ultrazohm/uz_d_gan_inverter/Produce/Layout/Einzel/README.TXT

READ ME
=======

Project Number	: 1166V10
Date		: 15.11.2020

Layout Drawing by: 
------------------
Michael Kutzsche
Kübrich Ingenieurgesellschaft
mbH & Co. KG
Weißmühle 10
D-96170 Priesendorf
Tel: +49/9549/9877-34
Fax: +49/9549/9877-55

Document descriptions
=====================
Dimension: 100 x 100 mm
min. Drill Hole 0.2 mm
Track-Thickness / Clearance 0.152 mm / 0.152 mm
CU-Thickness  35 µm (all Layer)

Gerberfile for PCB manufacturer:
--------------------------------
*.GTS	Top Solder Mask

*.GTL	Top Layer
*.G1	Mid Layer 1	
*.G2	Mid Layer 2
*.GBL	Bottom Layer

*.GBS	Bottom Solder Mask

*.GKO	Keep Out

*.DRL	NC Drill		(4.2/mm/lead/EIA)
*.TXT	NC Drill		(4.2/mm/lead/ASCII)
*.DDR	NC Drill Tool Table

Gerberfile for Components Assembler:
------------------------------------
*.GTP	Top Solder Paste
*.GBP	Bottom Solder Paste
