ultrazohm/uz_d_gan_inverter/Produce/Lotpaste/Nutzen/README.TXT

READ ME
=======

Project Number	: 1040V00
Date		: 20.02.2011

Layout Drawing by: 
------------------
Michael Kutzsche
Kübrich Ingenieurgesellschaft
mbH & Co. KG
Weißmühle 10
D-96170 Priesendorf
Tel: +49/9549/9877-34
Fax: +49/9549/9877-55

Gerberfile for Components Assembler:
------------------------------------
*.GTP	Top Solder Paste
*.GBP	Bottom Solder Paste
