ultrazohm/uz_d_gan_inverter/docs/Overview.pptx

6x Gate-Signals

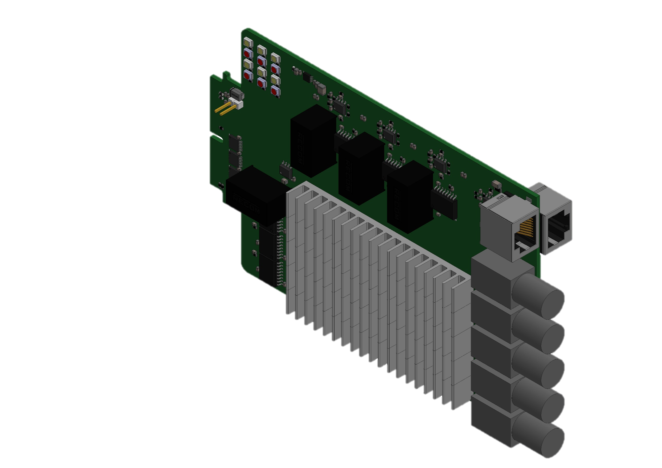
[picture p1: figure]

+24V Fan Connector

3x Phase to DC- Voltage

1x Enable

Fault LEDs

1x DC Current

6x Overcurrent

3x Phase-Current

6x Fault

1x DC+ to DC- Voltage

6x Temperature

4x Current Valid

+24V

+5V

DC+

+3.3V

DC-

GND

Phase a

Phase b

Phase c

## Slide 2

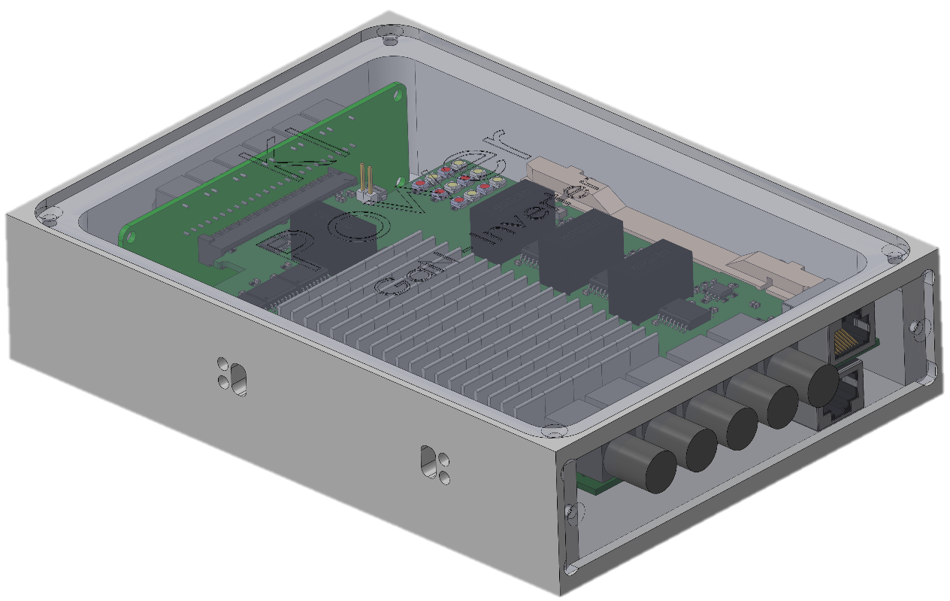
[picture p2: figure]
