ultrazohm/uz_d_gan_inverter/Designs/PCBs/1166V10.PcbDoc.htm

Reporting Options

# File in Newer Format

Date | : | 02.06.2021
Time | : | 14:03:46
Filename | : | C:\ZynqUltra\40_PCB_Design\uz_d_gan_inverter\Designs\PCBs\1166V10.PcbDoc

Version | Warning
Release 20.0 | CAUTION - Support of propagation delay for primitives

This file was generated by a later version of the software
