ultrazohm/uz_d_gan_inverter/CAD_Export/SolidWorks/1166V10.JPG

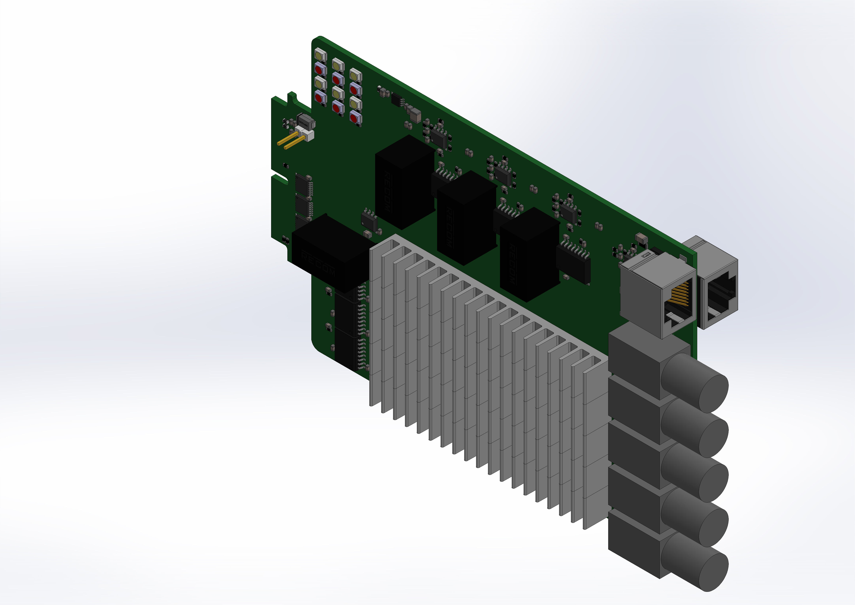
CAD_Export/SolidWorks/1166V10.JPG
