ultrazohm/uz_d_gan_inverter/docs/GaN_Overview.png

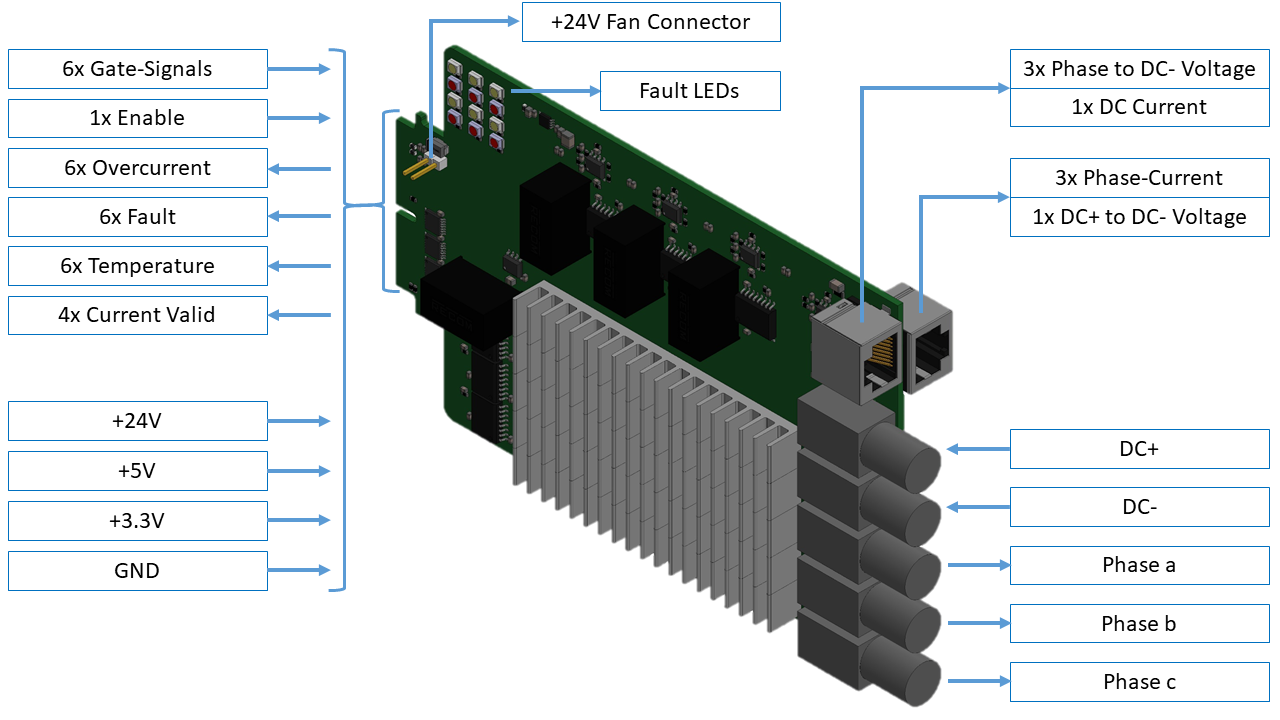
docs/GaN_Overview.png
