ultrazohm/uz_d_gan_inverter/heatsink/heatsink.png

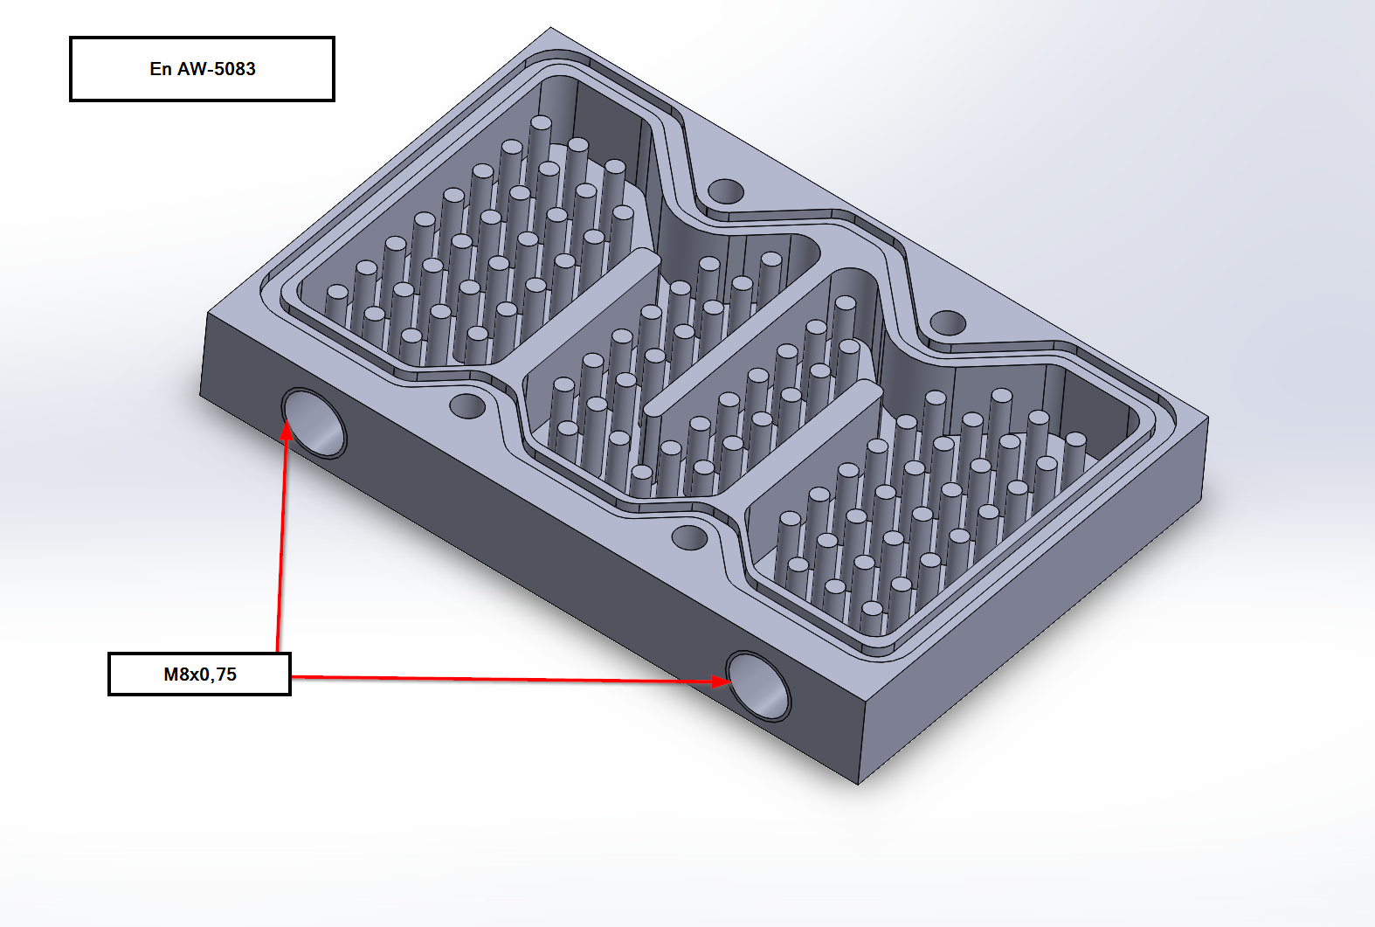
heatsink/heatsink.png
