ultrazohm/uz_d_gan_inverter/heatsink/heatsink_concept.png

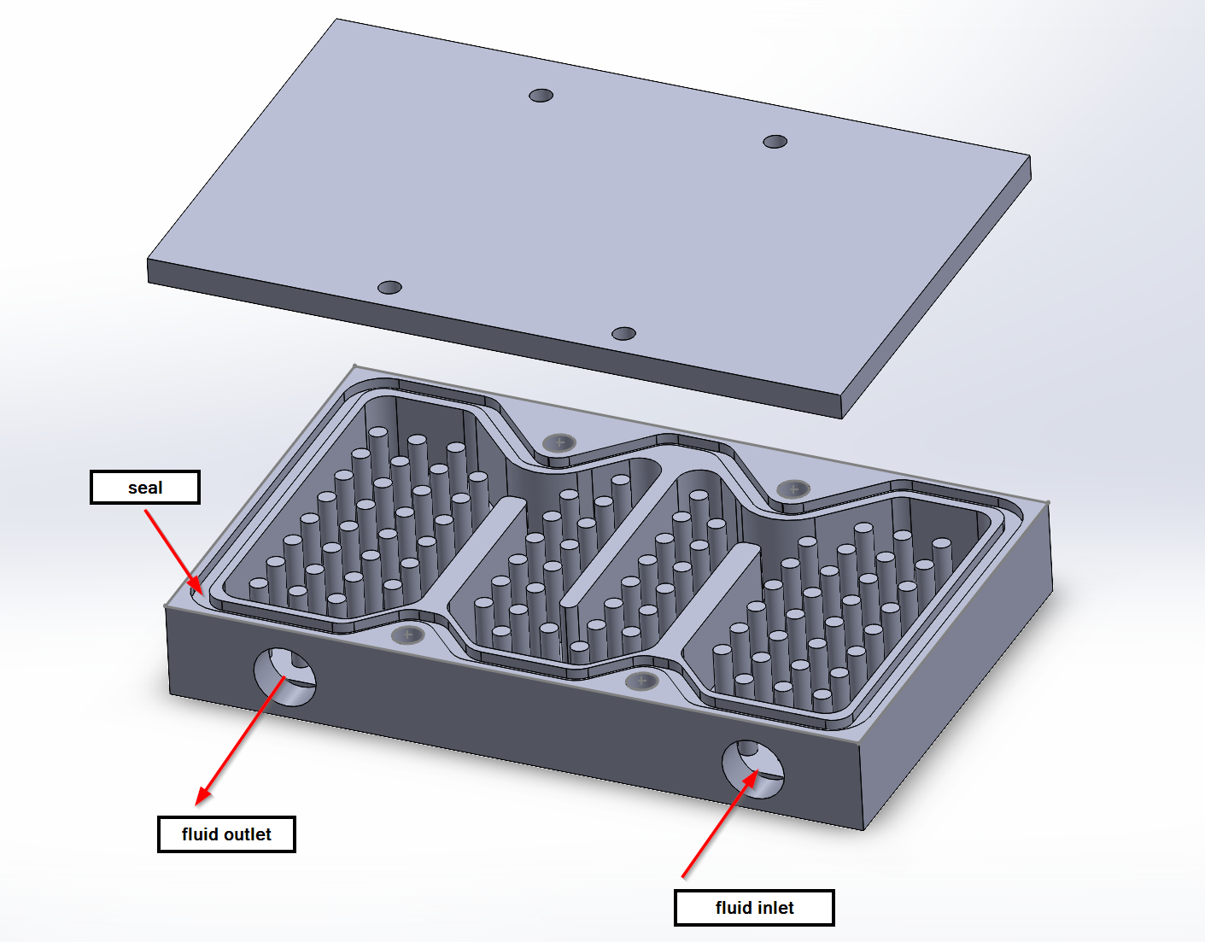
heatsink/heatsink_concept.png
