ultrazohm/uz_d_gan_inverter/heatsink/heatsink_cover.png

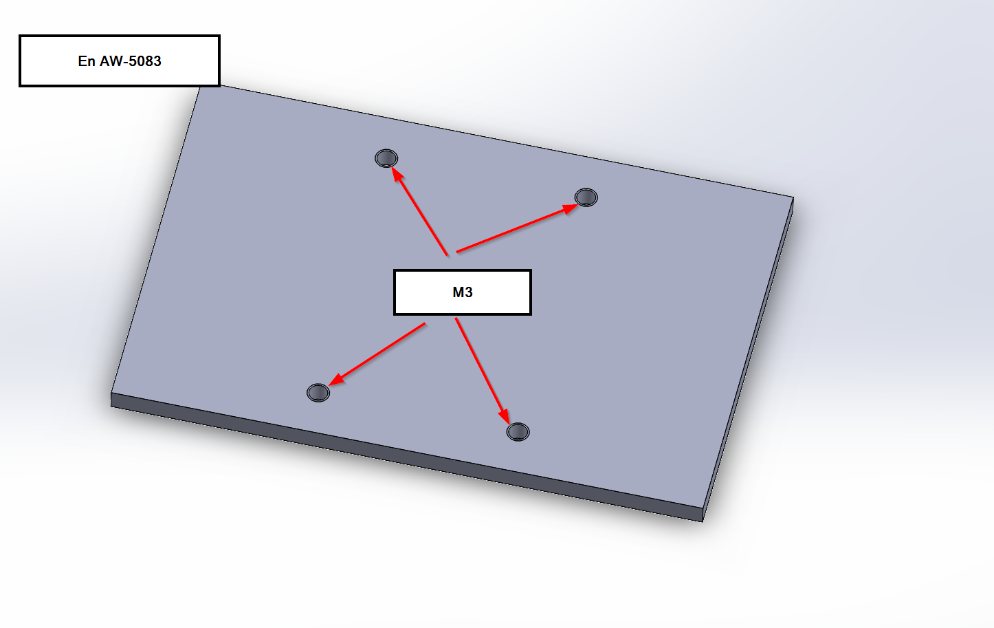
heatsink/heatsink_cover.png
