ultrazohm/uz_d_gan_inverter/heatsink/m8_075_stutzen.png

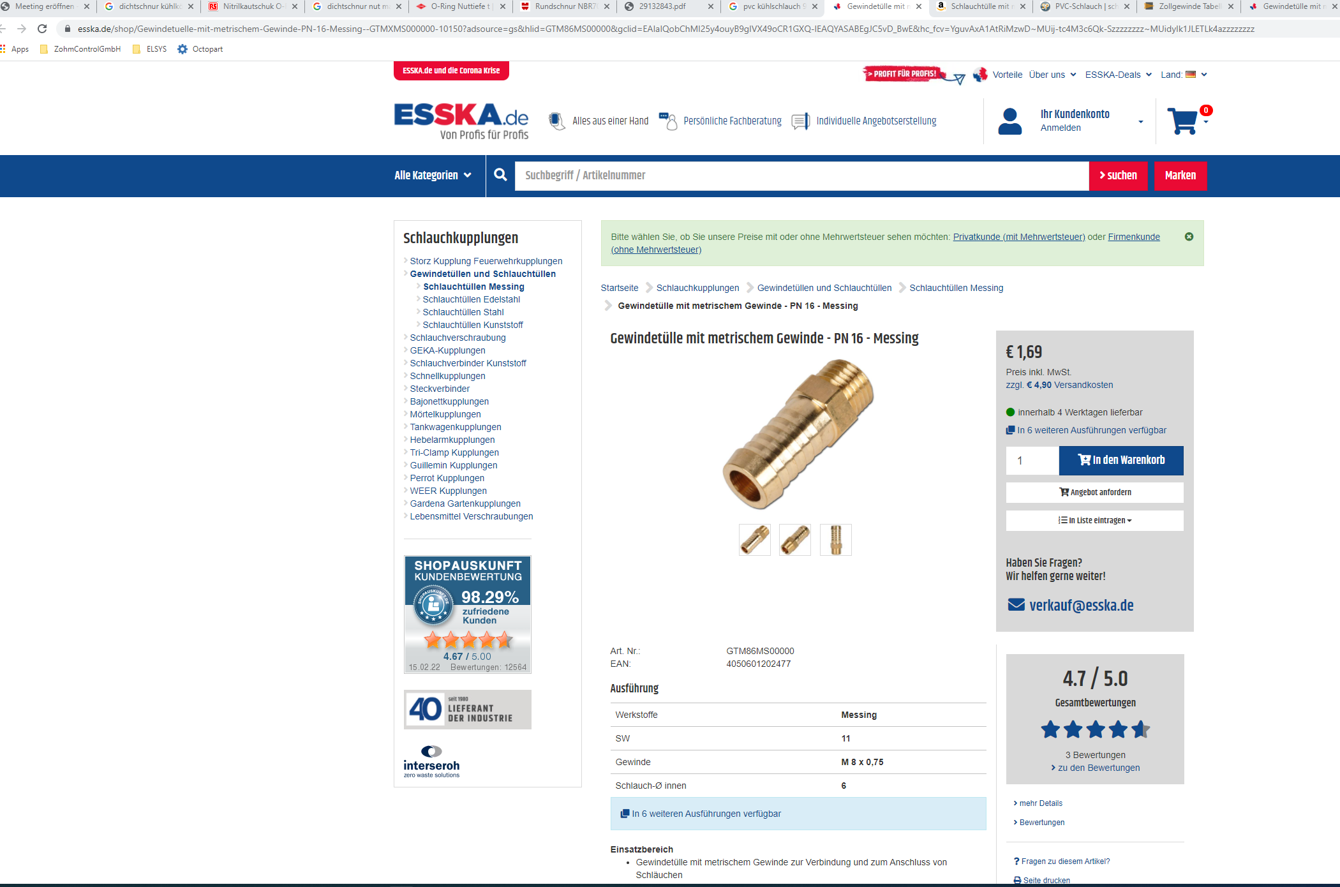
heatsink/m8_075_stutzen.png
