ultrazohm/uz_d_gan_inverter/Produce/Prints/1160V01 Stückliste.xls

Sheet: Stückliste
Stückliste |  |  |  | Bill of Materials for Variant [Variant V01] of Project [1160V01.PrjPCB] (No PCB Document Selected)
Projekt: |  |  |  | 1160V01.PrjPCB |  |  | Beist.: | Beigestell durch:
Variante: |  |  |  | Variant V01 |  |  |  | KI => Kübrich Ing.-Gesellschaft
Letzte(r) Bearbeiter(in) |  |  |  | M. Kutzsche |  |  |  | B => Bestücker
 |  |  |  |  |  |  |  | n.b. => nicht bestückt
Erstellungsdatum: |  |  | 03.09.2020 | 13:52 |  | Tolleranz der Widerstände, wenn nicht anders angegeben: |  |  | 1%
Ausgabedatum: |  |  | 2020-09-03 |  |  | Tolleranz der Kondensatoren, wenn nicht anders angegeben: |  |  | 10%
 |  |  |  |  |  | Tolleranz der Elektrolyt Kondens., wenn nicht anders angegeben: |  |  | 20%
 |  |  |  |  |  | Spannungen bei Kondesatoren, wenn nicht anders angegeben: |  |  | min. 25V
Pos. | Beist. | Stk. | Ref. | Bezeichnung | Wert | Gehäuse | Hersteller | Distributor | Bemerkung
 |  |  |  |  |  |  |  | (Best.-Nr.:)
 |  | Quantity | Designator | Description | Comment | Footprint | Manufacturer | Best.-Nr.
1 | B | 9 | C101, C103, C105, C109, C206, C301, CF203, CF204, CF206 | Capacitor (SMD) | 10µF/10V | 0603-Cap
2 | B | 44 | C102, C104, C106, C108, C110, C201, C207, C208, C302, C303, C304, C305, CF101, CF102, CF201, CF202, CF205, CF207, CF208, CF209, CF210, CF211, CF212, CF213, CF214, CF215, CF217, CF218, CF219, CF220, CF221, CF222, CF223, CF224, CF225, CF226, CF227, CF228, CF229, CF301, CF302, CF303, CF304, CF305 | Capacitor (SMD) | 100nF | 0603-Cap
3 | B | 1 | C107 | Capacitor (SMD) | 10µF/50V | 1206-Cap
4 | B | 2 | C202, C203 | Capacitor (SMD) | 12pF | 0603-Cap
5 | B | 2 | C204, C205 | Capacitor (SMD) | 10nF | 0603-Cap
6 | B | 1 | C306 | Capacitor (SMD) | 1nF | 0603-Cap
7 | B | 2 | CF216, CF230 | Capacitor (SMD) | 2µ2F/6V3 Ceramic | 0603-Cap
8 | B | 1 | CX101 | Capacitor (SMD) | 4n7F/500V | 1206-Cap
9 | B | 1 | D201 | Top 90° LED Green, 20mA, 40mcd, -40-85°C | KA-4040CGSK | LED-KA-4040 4x4mm | Kingbright | Farnell 207-9903
10 | B | 1 | D202 | Top 90° LED Red, 20mA, 80mcd, -40-85°C | KA-4040SURSK | LED-KA-4040 4x4mm | Kingbright | Farnell 207-9899
11 | B | 2 | D203, D204 | Dual Diode Shottky Diode serial 40V/250mA | BAT64-04 | SOT-23 | Siemens | RS 752-7852
12 | B | 1 | D301 | High Conductance Fast Diode | MMSD4148 | SOD-123 | Fairchild Semiconductor
13 | B | 1 | D302 | Asymmetrial DATA Line Protector for CAN 200W/24V | PESD1CAN | SOT-23 | NXP | Farnell 151-0703
14 | B | 1 | IC101 | Low drop Voltage Regulator 3,3V/800mA | LM1117DTX-3.3 | TO-252-3 | National Semiconductor | Farnell 948-6275
15 | B | 1 | IC102 | (TSSOP) 3V LVDS Quad CMOS Differential Receiver | DS90LV048ATMTC | TSSOP-16 | National Semiconductor
16 | B | 1 | IC103 | 3.3V LVDS Driver, 400Mbps | DSLVDS1001DBV | SOT-23-5 | National Semiconductor | Mouser: 595-DSLVDS1001DBVT
17 | B | 1 | IC104 | LDO 1.2V 500mA Regulator | TLV75512PDBVR | SOT-23-5 |  | DigiKey: 296-50409-1-ND
18 | B | 1 | IC201 | C2000 Microcontroller, -40-125°C, 1MB FLASH, 128KB RAM | TMS320F28377SPZPQ | HTQFP-100 (PZP0100N) | Texas Instruments | Mouser: 595-320F28377SPZPQ
19 | B | 1 | IC202 | 16Kx8 (128 Kbit) serial EEPROM -40-85°C (I2C-Interface) | 24CW1280T-I/OT | SOT-23-5 | Microchip | Farnell: 293-1148 (DigiKey: 24CW1280T-I/OTCT-ND)
20 | B | 1 | IC203 | Voltage References 2,5V, Accuracy 1mV, 3 ppm/°C | ADR441BRZ | SOIC-8-N | ANALOG DEVICES | Farnell 127-4158
21 | B | 1 | IC301 | Voltage References 4,096V, Accuracy 1mV, 3 ppm/°C | ADR444BRZ | SOIC-8-N | ANALOG DEVICES | Farnell 127-4151
22 | B | 1 | IC302 | Dual 16-Bit nanoDAC, ±1 LSB INL | AD5065BRUZ | TSSOP-14 | Analog Divices | R&S 697-6849
23 | B | 1 | IC303 | 4,5-36V, Rail-to-Rail OUT Operational Amplifier (-40-125°C) | OPA189IDBV | SOT-23-5 | Texas Instruments | Mouser: 595-OPA189IDBVR
24 | B | 1 | IC304 | 1Mbps Fault-Protected RS-485 Transceivers With Extended Common-Mode Range | SN65HVD1781D | SOIC-8-N | Texax Instruments | Farnell: 170-3343
25 | B | 1 | IC305 | LIN Transreciver, SOIC8 | TJA1020 | SOIC-8-N | NXP | Farnell 880-4583
26 | B | 1 | IC306 | CAN Transreciver, SO8 | TJA1042T/3 | SOIC-8-N | NXP | DigiKey
27 | B | 1 | J101 | ERF8 Serie (Male) 2x20 Pin 90° | ERM8-020-01-L-D-EM2-L-TR | ERM8-020-01-L-D-EM2-L-TR | Samtec | Samtec ERM8-020-01-L-D-EM2-L-TR
28 | B | 1 | J201 | Stiftleiste SMD 2x4 Pol. RM 1,27mm, WE-PHD SMD Connector stehend | Pin Header | IDC-8-SMD-1.27 | Würth Elektronik | WE-62130821021 (WE-62100821021)
29 | B | 14 | K101, K102, K103, K105, K106, K107, K108, K109, K110, K111, K301, K302, K303, K304 | Solid State Relays 150mA/100VDC, NO, 8 Ohm, -40-85°C | CPC1009N | SOP-4 | IXYS | Mouser: 849-CPC1009N
30 | B | 2 | K104, K112 | Ultra-small Package Flat Polarized Relay 5V/20mA (220VDC/5A) | IM03DGR | AGQ | TE | Farnell 162-9011
31 | B | 6 | L101, L102, L103, L201, L202, L301 | Ferrite SMD 600R@100MHz 1A (0603) | 600R@100MHz 1A | 0603-Ind | Wuerth-Elektronik | WE-742792651
32 | B | 1 | LP101 | Leiterplatte 34 x 72 mm, 4 Lagen (4x 35 µm) | 34 x 72 mm, 4 Lagen (4x 35 µm) | LP | Generic Manufacturer
33 | B | 3 | Q101, Q201, Q202 | NPN General Purpose Amplifier | BC817-40 | SOT-23 | Fairchild Semiconductor | Farnell 108-1225
34 | B | 18 | R101, R102, R103, R104, R105, R106, R108, R110, R111, R112, R114, R115, R116, R118, R309, R310, R313, R315 | Resistor SMD | 100R | 0603-Res
35 | B | 4 | R107, R202, R205, R208 | Resistor SMD | 2K2 | 0603-Res
36 | B | 8 | R109, R203, R206, R207, R215, R216, R316, R317 | Resistor SMD | 10K | 0603-Res
37 | B | 2 | R201, R204 | Resistor SMD | 120R | 0603-Res
38 | B | 2 | R209, R213 | Resistor SMD | 91K/0,1%/10ppm/K | 0603-Res
39 | B | 2 | R210, R211 | Resistor SMD | 4K7 | 0603-Res
40 | B | 2 | R212, R214 | Resistor SMD | 10K/0,1%/10ppm/K | 0603-Res
41 | B | 6 | R301, R306, R307, R308, R311, R312 | Resistor SMD | 1K | 0603-Res
42 | B | 1 | R302 | Resistor SMD | 33R | 0603-Res
43 | B | 3 | R303, R304, R305 | Resistor SMD | 10K/0,1%/10ppm/°C | 0603-Res
44 | B | 1 | R314 | Resistor SMD | 120R | 0805-Res
45 | B | 1 | RV201 | Resistor SMD | 0R | 0603-Res
46 | B | 1 | RX101 | Resistor SMD | 1M | 1206-Res
47 | B | 1 | X201 | SMD Quarz 20 MHz 12pF, -40 - +125°C, 20ppm/50ppm, 2,5x3,2mm | ABM8AIG-20.000MHZ-12-2Z-T3 | OSC-3.2x2.5x0.6mm |  | Digi Key: 535-13390-1-ND
Zusätzliches Material

Sheet: Projekt Information
Project Full Path | S:\Jobs\1160V01\Designs\1160V01.PrjPCB
Project Filename | 1160V01.PrjPCB
Variant Name | Variant V01
Data-Source Filename | 1160V01.PrjPCB
Data-Source Full Path | S:\Jobs\1160V01\Designs\1160V01.PrjPCB
Title | Bill of Materials for Variant [Variant V01] of Project [1160V01.PrjPCB] (No PCB Document Selected)
Total Quantity | 161
Report Time | 13:52
Report Date | 03.09.2020
Report Date & Tine | 03.09.2020 13:52
Output Name | Bill of Materials
Output Type | BOM_PartType
Output Generator Name | BOM
Output Generator Description | Bill of Materials
