ultrazohm/uz_d_gan_inverter/Produce/Prints/1160V10 Stückliste.xls

Sheet: Stückliste
Stückliste |  |  |  | Bill of Materials for Variant [Variant V10] of Project [1166V10.PrjPCB] (No PCB Document Selected)
Projekt: |  |  |  | 1166V10.PrjPCB |  |  | Beist.: | Beigestell durch:
Variante: |  |  |  | Variant V10 |  |  |  | KI => Kübrich Ing.-Gesellschaft
Letzte(r) Bearbeiter(in) |  |  |  | M. Kutzsche |  |  |  | B => Bestücker
 |  |  |  |  |  |  |  | n.b. => nicht bestückt
Erstellungsdatum: |  |  | 15.01.2021 | 15:52 |  | Tolleranz der Widerstände, wenn nicht anders angegeben: |  |  | 1%
Ausgabedatum: |  |  | 2021-01-15 |  |  | Tolleranz der Kondensatoren, wenn nicht anders angegeben: |  |  | 10%
 |  |  |  |  |  | Tolleranz der Elektrolyt Kondens., wenn nicht anders angegeben: |  |  | 20%
 |  |  |  |  |  | Spannungen bei Kondesatoren, wenn nicht anders angegeben: |  |  | min. 25V
Pos. | Beist. | Stk. | Ref. | Bezeichnung | Wert | Gehäuse | Hersteller | Distributor | Bemerkung
 |  |  |  |  |  |  |  | (Best.-Nr.:)
 |  | Quantity | Designator | Description | Comment | Footprint | Manufacturer | Best.-Nr.
1 | B | 1 | C101 | Capacitor (SMD) | 10µF/10V | 0805-Cap
2 | B | 63 | C102, C104, C107, C109, C208, C211, C217, C224, C228, C235, C308, C311, C317, C330, C408, C411, C417, C430, C502, C512, C518, CF101, CF102, CF103, CF104, CF105, CF106, CF107, CF108, CF109, CF110, CF111, CF112, CF204, CF209, CF210, CF211, CF213, CF214, CF304, CF306, CF307, CF308, CF310, CF311, CF404, CF406, CF407, CF408, CF410, CF411, CF501, CF502, CF504, CF505, CF507, CF508, CF509, CF510, CF511, CF512, CF513, CF514 | Capacitor (SMD) | 100nF | 0603-Cap
3 | B | 1 | C103 | Capacitor (SMD) | 2µ2F/10V | 0805-Cap
4 | B | 1 | C105 | Capacitor (SMD) | 47µF/10V | 1210-Cap
5 | B | 2 | C106, C108 | Capacitor (SMD) | 10µF/10V | 0603-Cap
6 | B | 6 | C201, C225, C301, C322, C401, C422 | Capacitor (SMD) | 10µF/25V | 0805-Cap
7 | B | 3 | C202, C302, C402 | Capacitor (SMD) | 22nF/1KV | 2220-Cap
8 | B | 6 | C203, C204, C303, C304, C403, C404 | Capacitor (SMD) | 100nF/630V | 2220-Cap
9 | B | 10 | C205, C305, C405, C521, C522, C523, C524, C525, C526, C527 | Capacitor (SMD) | 1µF/630V | 2220-Cap
10 | B | 8 | C206, C207, C222, C223, C306, C307, C406, C407 | Capacitor (SMD) | 10µF/50V | 1206-Cap
11 | B | 6 | C209, C226, C309, C323, C409, C423 | Capacitor (SMD) | 220nF | 0603-Cap
12 | B | 6 | C210, C227, C310, C324, C410, C424 | Capacitor (SMD) | 2µ2F/25V | 0805-Cap
13 | B | 4 | C212, C312, C412, C505 | Capacitor (SMD) | 1µF/25V | 1206-Cap
14 | B | 8 | C213, C218, C313, C318, C413, C418, C506, C513 | Capacitor (SMD) | 1nF | 1206-Cap
15 | B | 5 | C215, C315, C415, C510, CF305 | Capacitor (SMD) | 1µF/25V | 0603-Cap
16 | B | 4 | C216, C316, C416, C511 | Capacitor (SMD) | 1nF | 0603-Cap
17 | B | 4 | C219, C319, C419, C514 | Capacitor (SMD) | 100nF | 1206-Cap
18 | B | 4 | C220, C320, C420, C515 | Capacitor (SMD) | 8n2F | 0603-Cap
19 | B | 6 | C221, C231, C321, C326, C421, C426 | Capacitor (SMD) | 68pF | 0603-Cap
20 | B | 1 | C229 | Capacitor (SMD) | 10nF | 0603-Cap
21 | B | 16 | C232, C237, C327, C332, C427, C432, C501, C508, C509, C520, C528, C531, C533, C537, C538, C542 | Capacitor (SMD) | 22pF | 0603-Cap
22 | B | 24 | C233, C234, C236, C328, C329, C331, C428, C429, C431, C503, C504, C507, C516, C517, C519, C529, C530, C532, C534, C535, C536, C539, C540, C541 | Capacitor (SMD) | 2n2F | 0603-Cap
23 | B | 9 | CF201, CF202, CF205, CF206, CF207, CF301, CF302, CF401, CF402 | Capacitor (SMD) | 22µF/16V | 0805-Cap
24 | B | 13 | CF203, CF208, CF212, CF215, CF303, CF309, CF312, CF403, CF405, CF409, CF412, CF503, CF506 | Capacitor (SMD) | 1µF/10V | 0603-Cap
25 | B | 1 | CX101 | Capacitor (SMD) | 4n7F/500V | 1206-Cap
26 | B | 1 | D101 | Schottky Barrier Rectifier Vr=60V If=1A | B160 | SMA | General Semiconductor | Farnell 145-6528RL
27 | B | 6 | D201, D206, D301, D306, D401, D406 | Silicon Carbide Schottky Diode Vr=1200V If=1A | GB01SLT12-214 | DO-214 (SMB) | GeneSiC Semiconductor | DigiKey: 1242-1169-1-ND
28 | B | 6 | D202, D204, D302, D304, D402, D404 | Top LED Super red, 2mA, 18mcd, -40-100°C | VLMS30K1L2-GS08 | PLCC-2_rot | Vishay | Farnell 132-8349
29 | B | 6 | D203, D205, D303, D305, D403, D405 | Top LED Yellow, 2mA, 18mcd, -40-100°C | VLMY3001 | PLCC-2_gelb | Vishay | ???
30 | B | 3 | IC101, IC105, IC109 | Dual 4-Input AND Gate with Schmitt Trigger Input | SN74HCS21PWR | TSSOP-14 | Texas Instrument | DigiKey: 296-SN74HCS21PWRCT-ND
31 | B | 3 | IC102, IC106, IC110 | (VSSOP) Dual 2-Input Positive AND Gate | SN74AUP2G08DCUR | VSSOP-8 | Texas Instrument
32 | B | 3 | IC103, IC107, IC111 | Dual Buffer with Schmitt Trigger Input | SN74LVC2G17DBV | SOT-23-6 | Texas Instrument | Farnell 147-0776 (SOT23-6), 128-7569 (SC-70)
33 | B | 3 | IC104, IC108, IC113 | Dual Inverter with Schmitt Trigger Input | SN74LVC2G14DBV | SOT-23-6 | Texas Instrument
34 | B | 1 | IC112 | Voltage References 2,5V, 2ppm/°C, Low Noise 0,25ppm | LTC6655BHMS8-2.5 | MSOP-8 (RM-8) | Linear Technology | Farnell 229-5508
35 | B | 4 | IC201, IC301, IC401, IC501 | ±250 mV Input Voltage Range, Reinforced Isolated Amplifier and High Bandwidth of 300 kHz | AMC3301DWE | SOIC-16-W - 8.1mm | Texas Instruments | DigiKey: 296-AMC3301DWE-ND
36 | B | 6 | IC202, IC204, IC302, IC303, IC402, IC403 | Quad-CH 100Mbps Isolators 1 IN/3 OUT, 5000V Reinforced, (-40-150°C) | ISO7741FEDWQ1 | SOIC-16-W - 8.1mm | Anaolog Devices | DigiKey: 296-ISO7741FEDWQ1-ND
37 | B | 1 | IC203 | LDO 5V/500mA, Vin 20V (-40-125°C) | LT1763IS8-5#PBF | SOIC-8-N | Linear Technology | Farnell 229-5214
38 | B | 4 | IC205, IC304, IC404, IC503 | 2V Input, Automotive High-Impedance, Reinforced Isolated Amplifier for Voltage Sensing | AMC1311BQDWVRQ1 | SOIC-8-W | Texas Instruments | Mouser: 595-AMC1311BQDWVRQ1
39 | B | 8 | IC206, IC305, IC405, IC502, IC504, IC505, IC506, IC507 | Fully Differential ADC Drivers (-40-125°C) | ADA4940-1ARZ | SOIC-8-N | ANALOG DEVICES | Farnell 209-6178
40 | B | 2 | J103, J104 | SMD CAT3 RJ-45 Connector | RJ-45 | WE-634008149821 | Würth Elektronik | WE-634008149821
41 | B | 3 | J201, J301, J401 | Labor Winkelbuchsen 4mm Schwarz | MC - SLB4-I/90 Schwarz | SLB4-I/90 - 4mm | Multi-Contact | Farnell: 108-5521
42 | B | 1 | J501 | Labor Winkelbuchsen 4mm Rot | MC - SLB4-I/90 Rot | SLB4-I/90 - 4mm | Multi-Contact | Farnell: 413-0261
43 | B | 1 | J502 | Labor Winkelbuchsen 4mm Blau | FCR7350L Blau | SLB4-I/90 - 4mm - CLIFF | CLIFF Electronic | Farnell: 185-4511
44 | B | 3 | L101, L102, L103 | Ferrite SMD 600R@100MHz 1A (0603) | 600R@100MHz 1A | 0603-Ind | Wuerth-Elektronik | WE-742792651
45 | B | 8 | L201, L202, L204, L205, L301, L302, L401, L402 | 100µH, 60/120mA. (1007), -40-105°C | 100µH/120mA | 1007-IND (2518) | Taiyo Yuden | DigiKey: 587-2192-1-ND
46 | B | 6 | L203, L206, L303, L304, L403, L404 | Power Choke 4u7H 1,1A | 4u7H 1,1A | 2.0mm x 1.6mm | Delta Electronics/Cyntec | DigiKey: 2037-SDEM20161T-4R7MSCT-ND
47 | B | 1 | LP101 | Leiterplatte 100 x 156 mm, 8 Lagen (8x 70 µm) | 100 x 156 mm, 8 Lagen (8x 70 µm) | LP | Generic Manufacturer
48 | B | 3 | PS201, PS301, PS401 | DC/DC Converter 24V to 12V, 1W, 84mA (unregulated) 6,4KVDC Rainforced | R24P12S/P/X2/R6.4 | SIP-7 Single - X2 | Recom | Mouser: 919-R24P12SX2PR6.4
49 | B | 1 | PS202 | DC/DC Converter 24V to 12V, 2W, 167mA (unregulated) 6,4KVDC Rainforced | R24P212S/P/X2/R6.4 | SIP-7 Single - X2 | Recom | Mouser: 919-R24P212SX2PR6.4
50 | B | 6 | Q201, Q202, Q301, Q302, Q401, Q402 | GaN FET Power Stage With Cycle-by-cycle Overcurrent Protection 600V/40A/30mOhm | LMG3425R030RQZT | VQFN-54 (RQZ0054) | Texas Instruments | TI-Shop
51 | B | 5 | R101, R203, R303, R403, R502 | Resistor SMD | 10K | 0603-Res
52 | B | 1 | R103 | Resistor SMD | 0R | 0603-Res
53 | B | 12 | R201, R202, R204, R207, R301, R302, R304, R307, R401, R402, R404, R407 | Resistor SMD | 470R | 0603-Res
54 | B | 4 | R205, R212, R312, R412 | Resistor SMD | 20K | 0603-Res
55 | B | 6 | R206, R213, R306, R313, R406, R413 | Resistor SMD | 220R | 0603-Res
56 | B | 38 | R208, R214, R216, R218, R221, R223, R308, R314, R316, R318, R321, R323, R408, R414, R416, R418, R421, R423, R503, R505, R506, R508, R513, R515, R519, R521, R525, R527, R529, R531, R532, R534, R536, R538, R541, R543, R544, R546 | Resistor SMD | 49R9 | 0603-Res
57 | B | 8 | R209, R210, R309, R310, R409, R410, R516, R517 | Resistor SMD | 10R | 0603-Res
58 | B | 3 | R211, R311, R411 | 18mOhm, 3W, 0,5%, 50ppm/°C | 0.018R | 2512 | Milticomp | Farnell: 282-8111
59 | B | 16 | R215, R225, R315, R325, R415, R425, R501, R509, R510, R523, R524, R528, R535, R539, R540, R547 | Resistor SMD | 2K | 0603-Res
60 | B | 16 | R217, R222, R317, R322, R417, R422, R504, R507, R514, R520, R526, R530, R533, R537, R542, R545 | Resistor SMD | 1K | 0603-Res
61 | B | 8 | R219, R220, R319, R320, R419, R420, R511, R512 | Resistor SMD 1M/0,1%/3KV/2W/25ppm/°C | 1M | 2512-Res |  | DigiKey: HVCB2512BDE1M00CT-ND
62 | B | 4 | R224, R324, R424, R522 | Resistor SMD | 6K65/0,1%/10ppm | 0603-Res
63 | B | 2 | R305, R405 | Resistor SMD | 15K | 0603-Res
64 | B | 1 | R518 | 10mOhm, 3W, 1%, 50ppm/°C | 0.010R | 2512 | TT Electronics | Farnell: 207-9429
65 | B | 1 | RX101 | Resistor SMD | 1M | 1206-Res
Zusätzliches Material

Sheet: Projekt Information
Project Full Path | S:\Jobs\1166V10\Designs\1166V10.PrjPCB
Project Filename | 1166V10.PrjPCB
Variant Name | Variant V10
Data-Source Filename | 1166V10.PrjPCB
Data-Source Full Path | S:\Jobs\1166V10\Designs\1166V10.PrjPCB
Title | Bill of Materials for Variant [Variant V10] of Project [1166V10.PrjPCB] (No PCB Document Selected)
Total Quantity | 427
Report Time | 15:52
Report Date | 15.01.2021
Report Date & Tine | 15.01.2021 15:52
Output Name | Bill of Materials
Output Type | BOM_PartType
Output Generator Name | BOM
Output Generator Description | Bill of Materials
