ultrazohm/uz_d_gan_inverter/CAD_Export/SolidWorks/Assembly_water_cooled.SLDASM

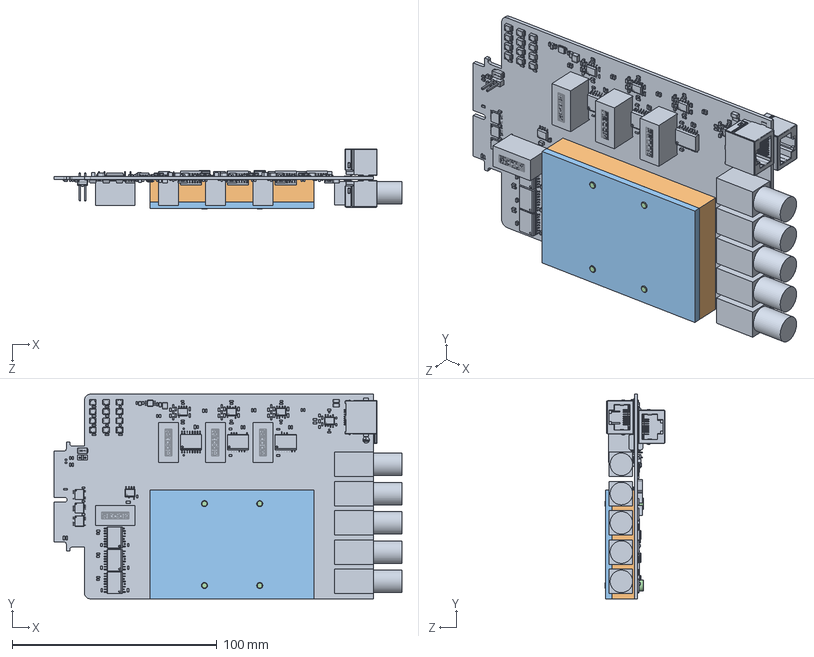
[picture p9: CAD file, 2022-02-21]
CAD_Export/SolidWorks/Assembly_water_cooled.SLDASM
170.0 x 100.0 x 29.5 mm
1166V10
heatsink2
heatsink_plate
socket head cap screw 4762_din x 4
