ultrazohm/uz_d_gan_inverter/heatsink/heatsink_assembly.SLDASM

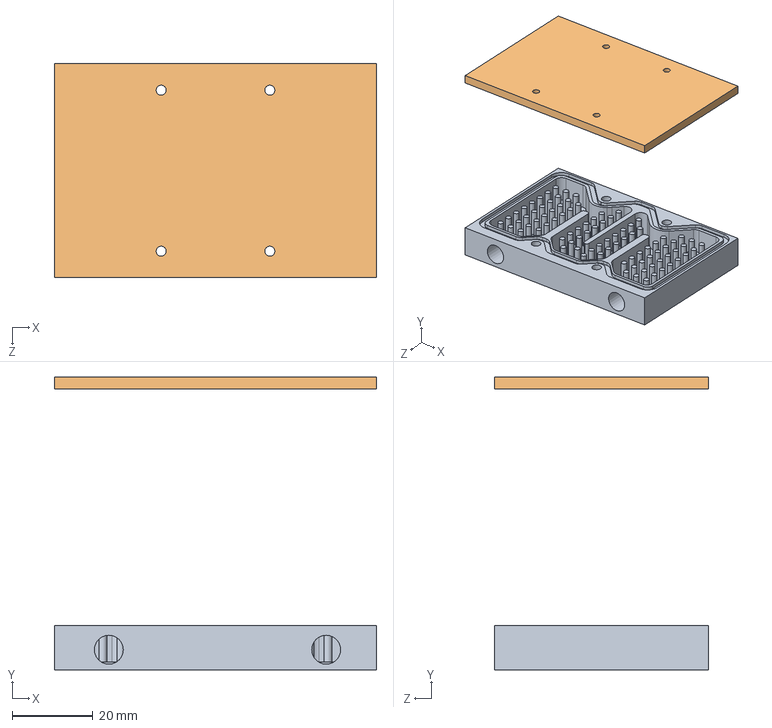
[picture p10: CAD file, 2022-02-21]
heatsink/heatsink_assembly.SLDASM
80.0 x 72.7 x 53.1 mm
heatsink2
heatsink_plate
