ultrazohm/uz_d_gan_inverter/CAD_Export/FrontPanel/UZ_D_GaN_Inverter.dxf

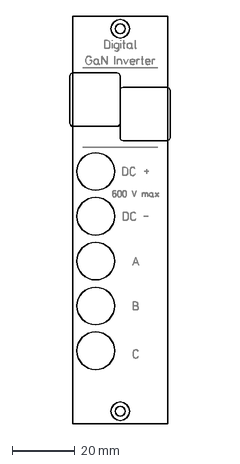
[picture p11: CAD file, 2021-09-15]
CAD_Export/FrontPanel/UZ_D_GaN_Inverter.dxf
32.0 x 130.0 mm
