ultrazohm/uz_d_gan_inverter/heatsink/heatsink2.STEP

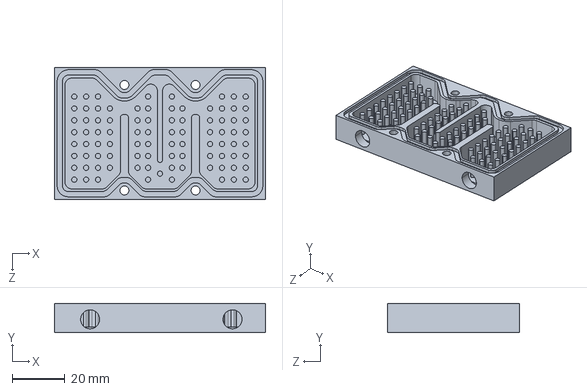
[picture p12: CAD file, 2022-02-21]
heatsink/heatsink2.STEP
80.0 x 11.0 x 50.0 mm
