ultrazohm/uz_d_gan_inverter/heatsink/step/heatsink.STEP

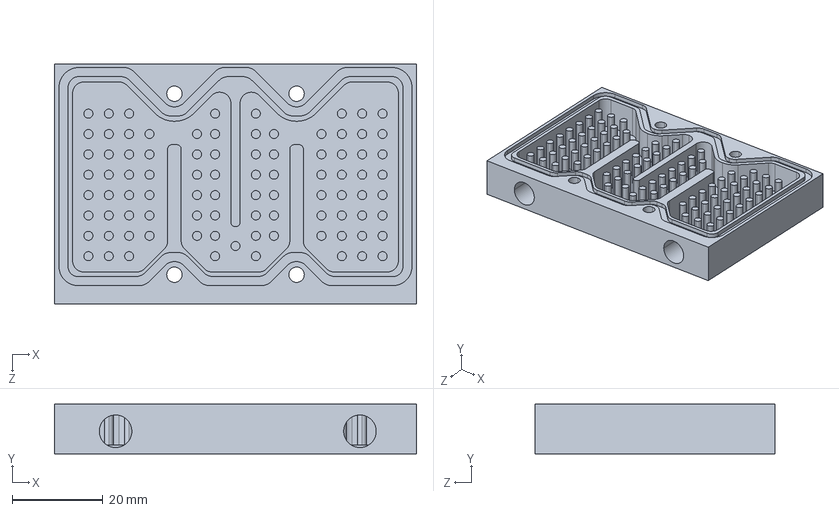
[picture p13: CAD file, 2022-02-21]
heatsink/step/heatsink.STEP
80.0 x 11.0 x 53.1 mm
