ultrazohm/uz_d_gan_inverter/CAD_Export/FrontPanel/UZ_D_GaNInverter_Panel.SLDPRT

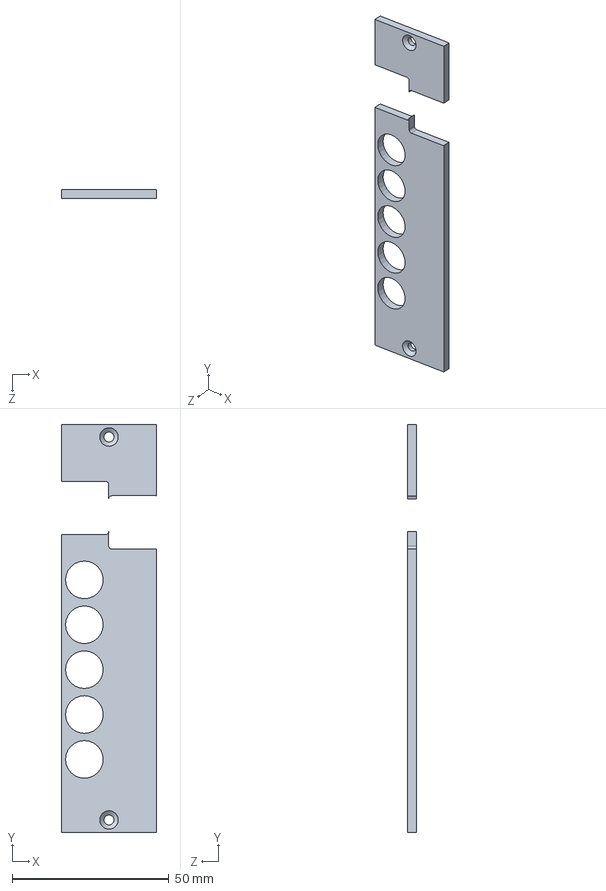
[picture p14: CAD file, 2021-09-15]
CAD_Export/FrontPanel/UZ_D_GaNInverter_Panel.SLDPRT
30.2 x 130.0 x 3.00 mm
