ultrazohm/uz_d_gan_inverter/heatsink/step/heatsink_cover.STEP

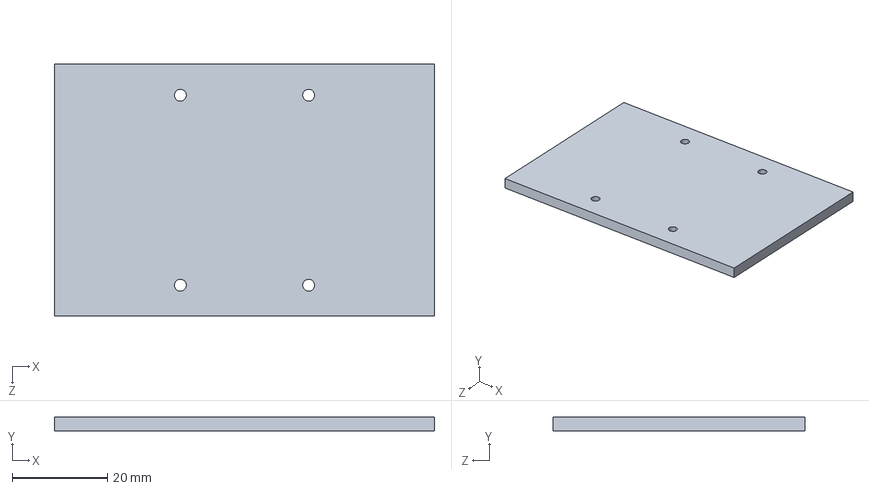
[picture p15: CAD file, 2022-02-21]
heatsink/step/heatsink_cover.STEP
80.0 x 3.00 x 53.1 mm
