ultrazohm/uz_d_gan_inverter/(list of files, cad)

Other CAD files:
heatsink/heatsink_plate.SLDPRT
heatsink/heatsink.SLDPRT
heatsink/heatsink2.SLDPRT
heatsink/step/heatsink.SLDPRT
