ultrazohm/uz_d_gan_inverter/measurements/20210902_Messung_GaN.xlsx

Messung GaN Adapter Board
HW Version: | 1166V10
Datum: | 2021-09-02
Lastmaschine
Drehzahl: | -500 | rpm
Prüfling:
U_ZK | 48 V |  |  | 24 V | 36 V | 36
PWM Frequenz | 100 kHz |  |  | 100 kHz | 200 kHz | 200 kHz
Totzeit | 18 ns |  |  | 18 ns | 50 ns | 50 ns
iq_strom | 20 | 20 | 25 | 25 | 10 | 15
DC Strom | 2.5 | 2.5 | 3.6 | 6.8 | 2.1 | 3.3
Temperatur | >165 °C an H1 | 100 °C | 147 °C an H1 | 151 °C an H3 | 90 °C an H2 | 131 °C an H2
Kühlung | ohne Lüfter | mit Lüfter | mit Lüfter | mit Lüfter | ohne Lüfter | ohne Lüfter
Notiz | nach 2min OT | nach 5min, Eingeschwungen | nach 5min, Eingeschwungen | nach 5min, Eingeschwungen | nach 1h, Eingeschwungen
 |  |  |  |  |  | 118.8
