ultrazohm/uz_d_gan_inverter/Produce/Prints/1166V10 Schematic.pdf

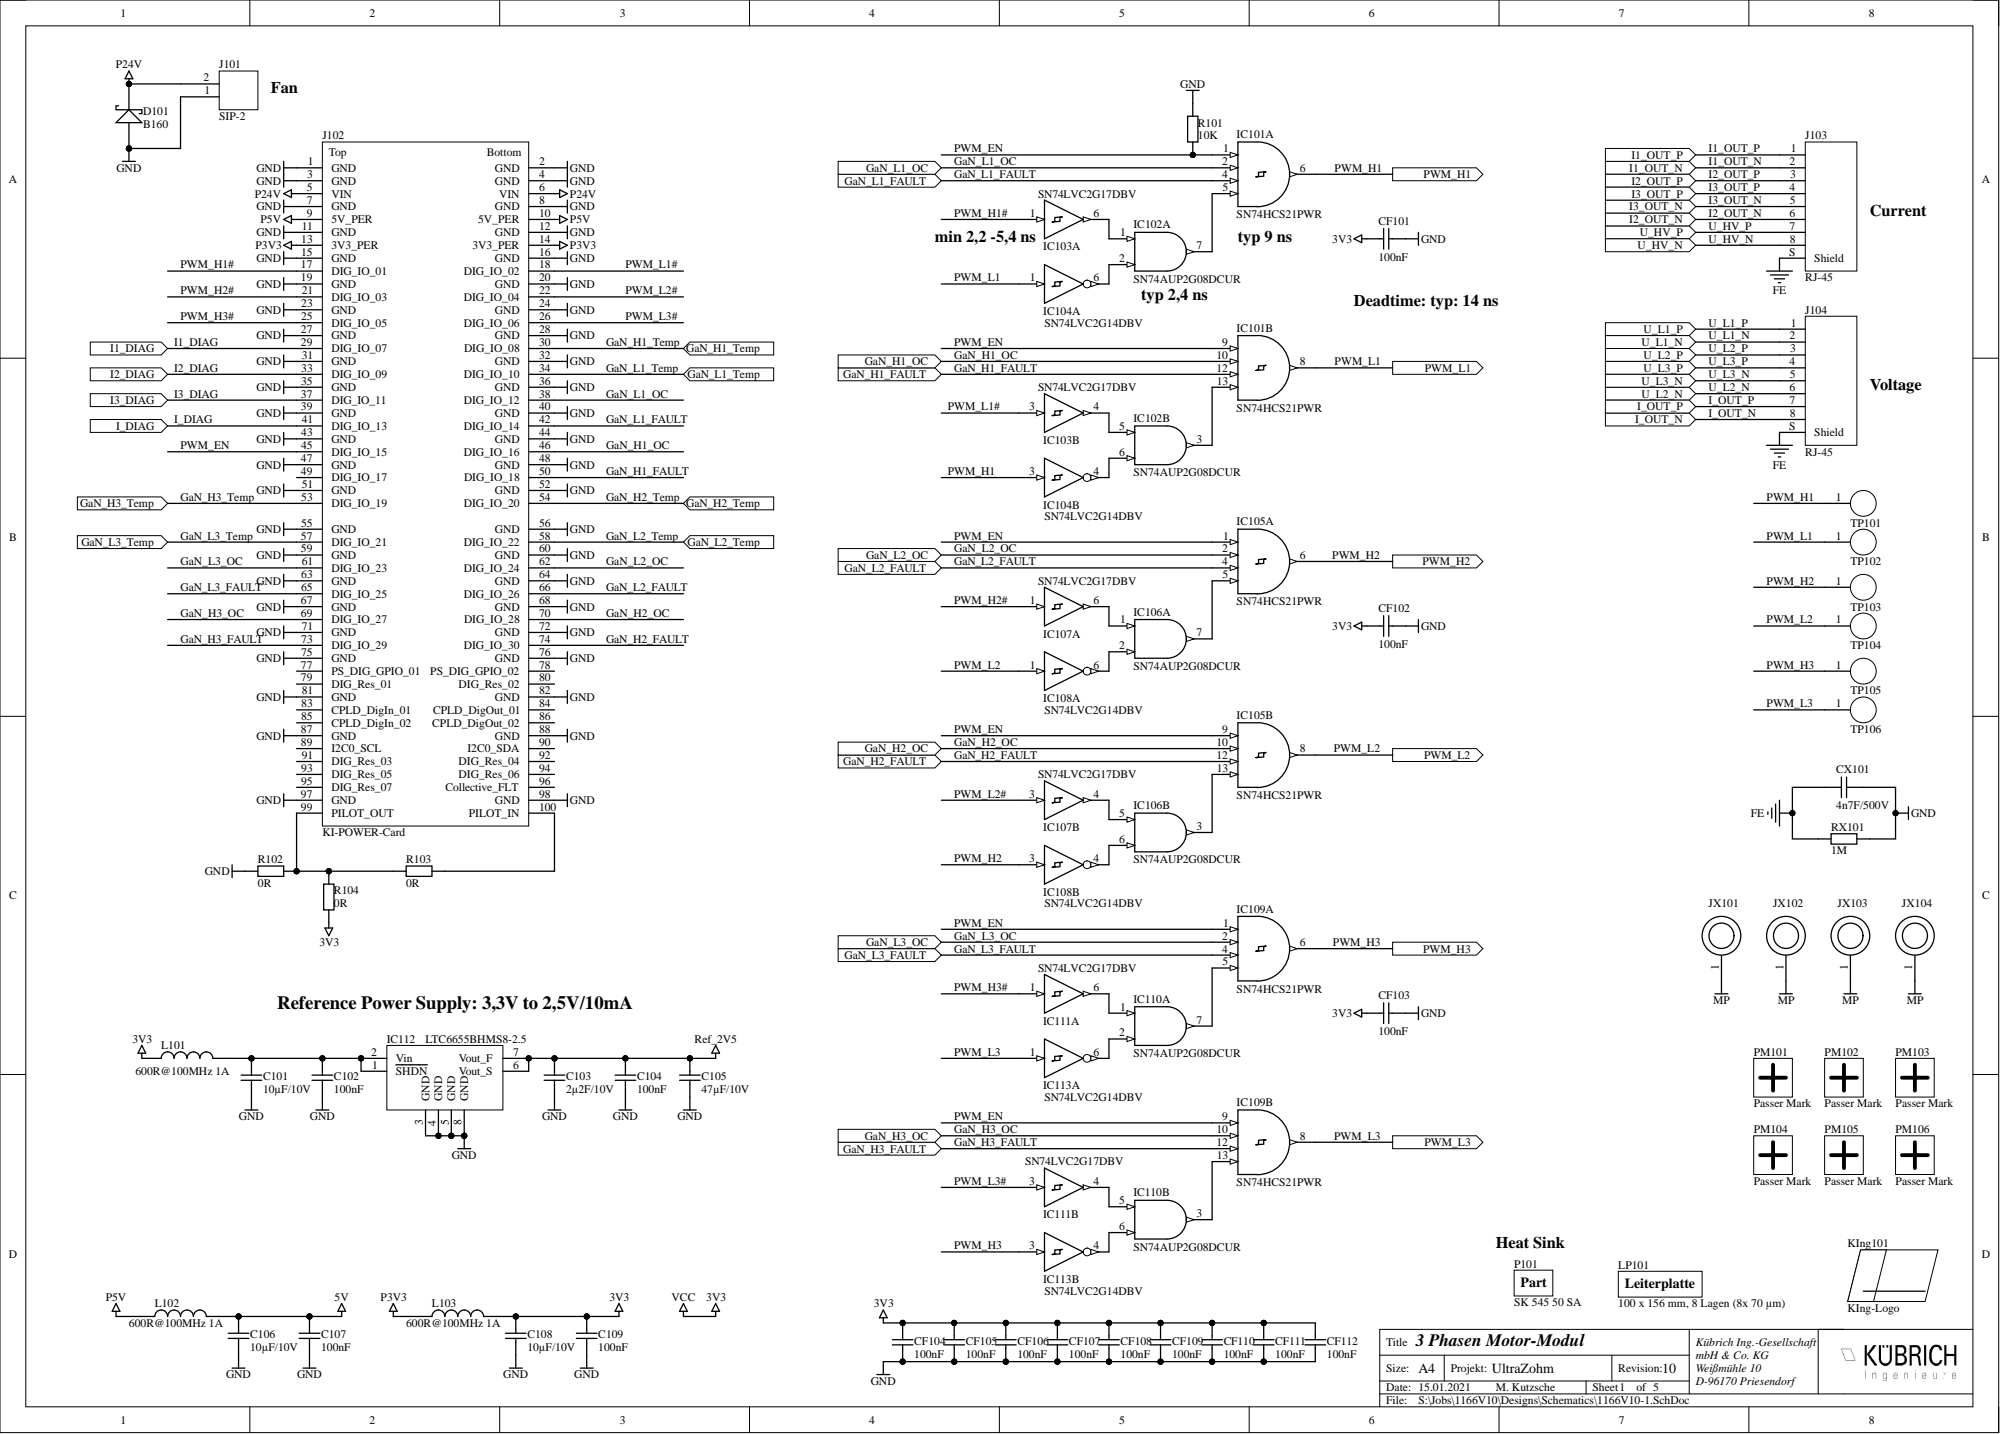
[picture p16: page 1]

Reference Power Supply: 3,3V to 2,5V/10mA

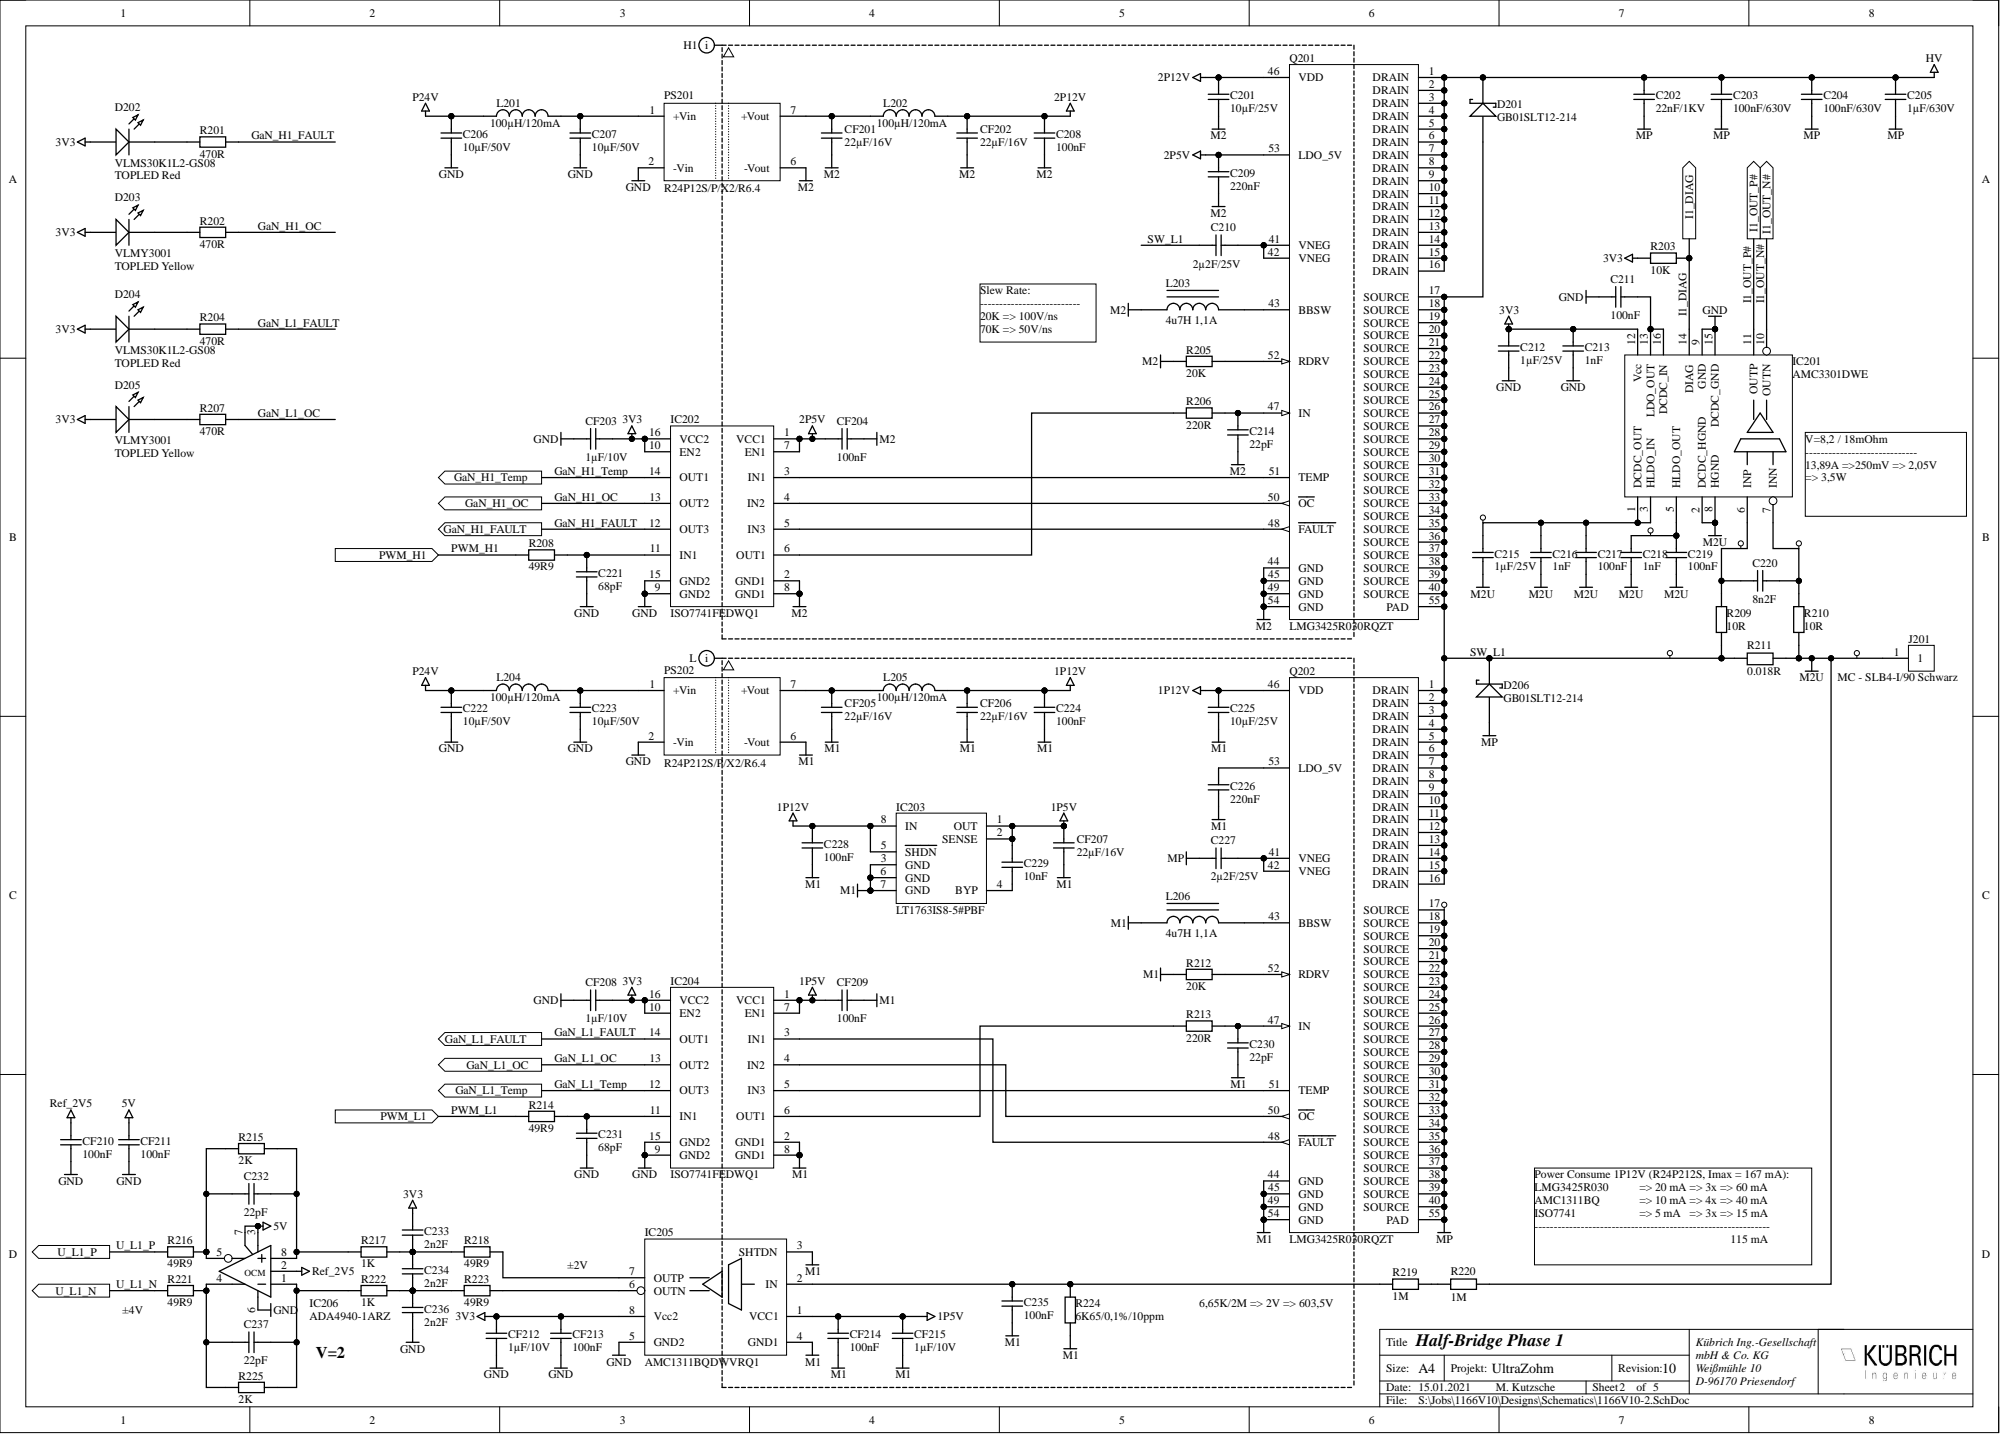
[picture p17: page 2]

2P5V CF204 | C214 220R M2 | TEMP 51

VCC2 16 | EN1 IN1 IN2 IN3
EN2 10 | | 7 | 100nF

OUT1 14 OUT2 13 OUT3 12 IN1 11 | 3

5 | | FAULT 48

C228 | SHDN 5

GND 3

VCC2 16 | EN1 IN2 IN3 OUT1 GND1
EN2 10 | 7

TEMP 51

GND2 9 GND2 15 | | | GND 44

2 | FAULT 48

Power Consume 1P12V (R24P212S, Imax = 167 mA):

S:\Jobs\1166V10\Designs\Schematics\1166V10-2.SchDoc

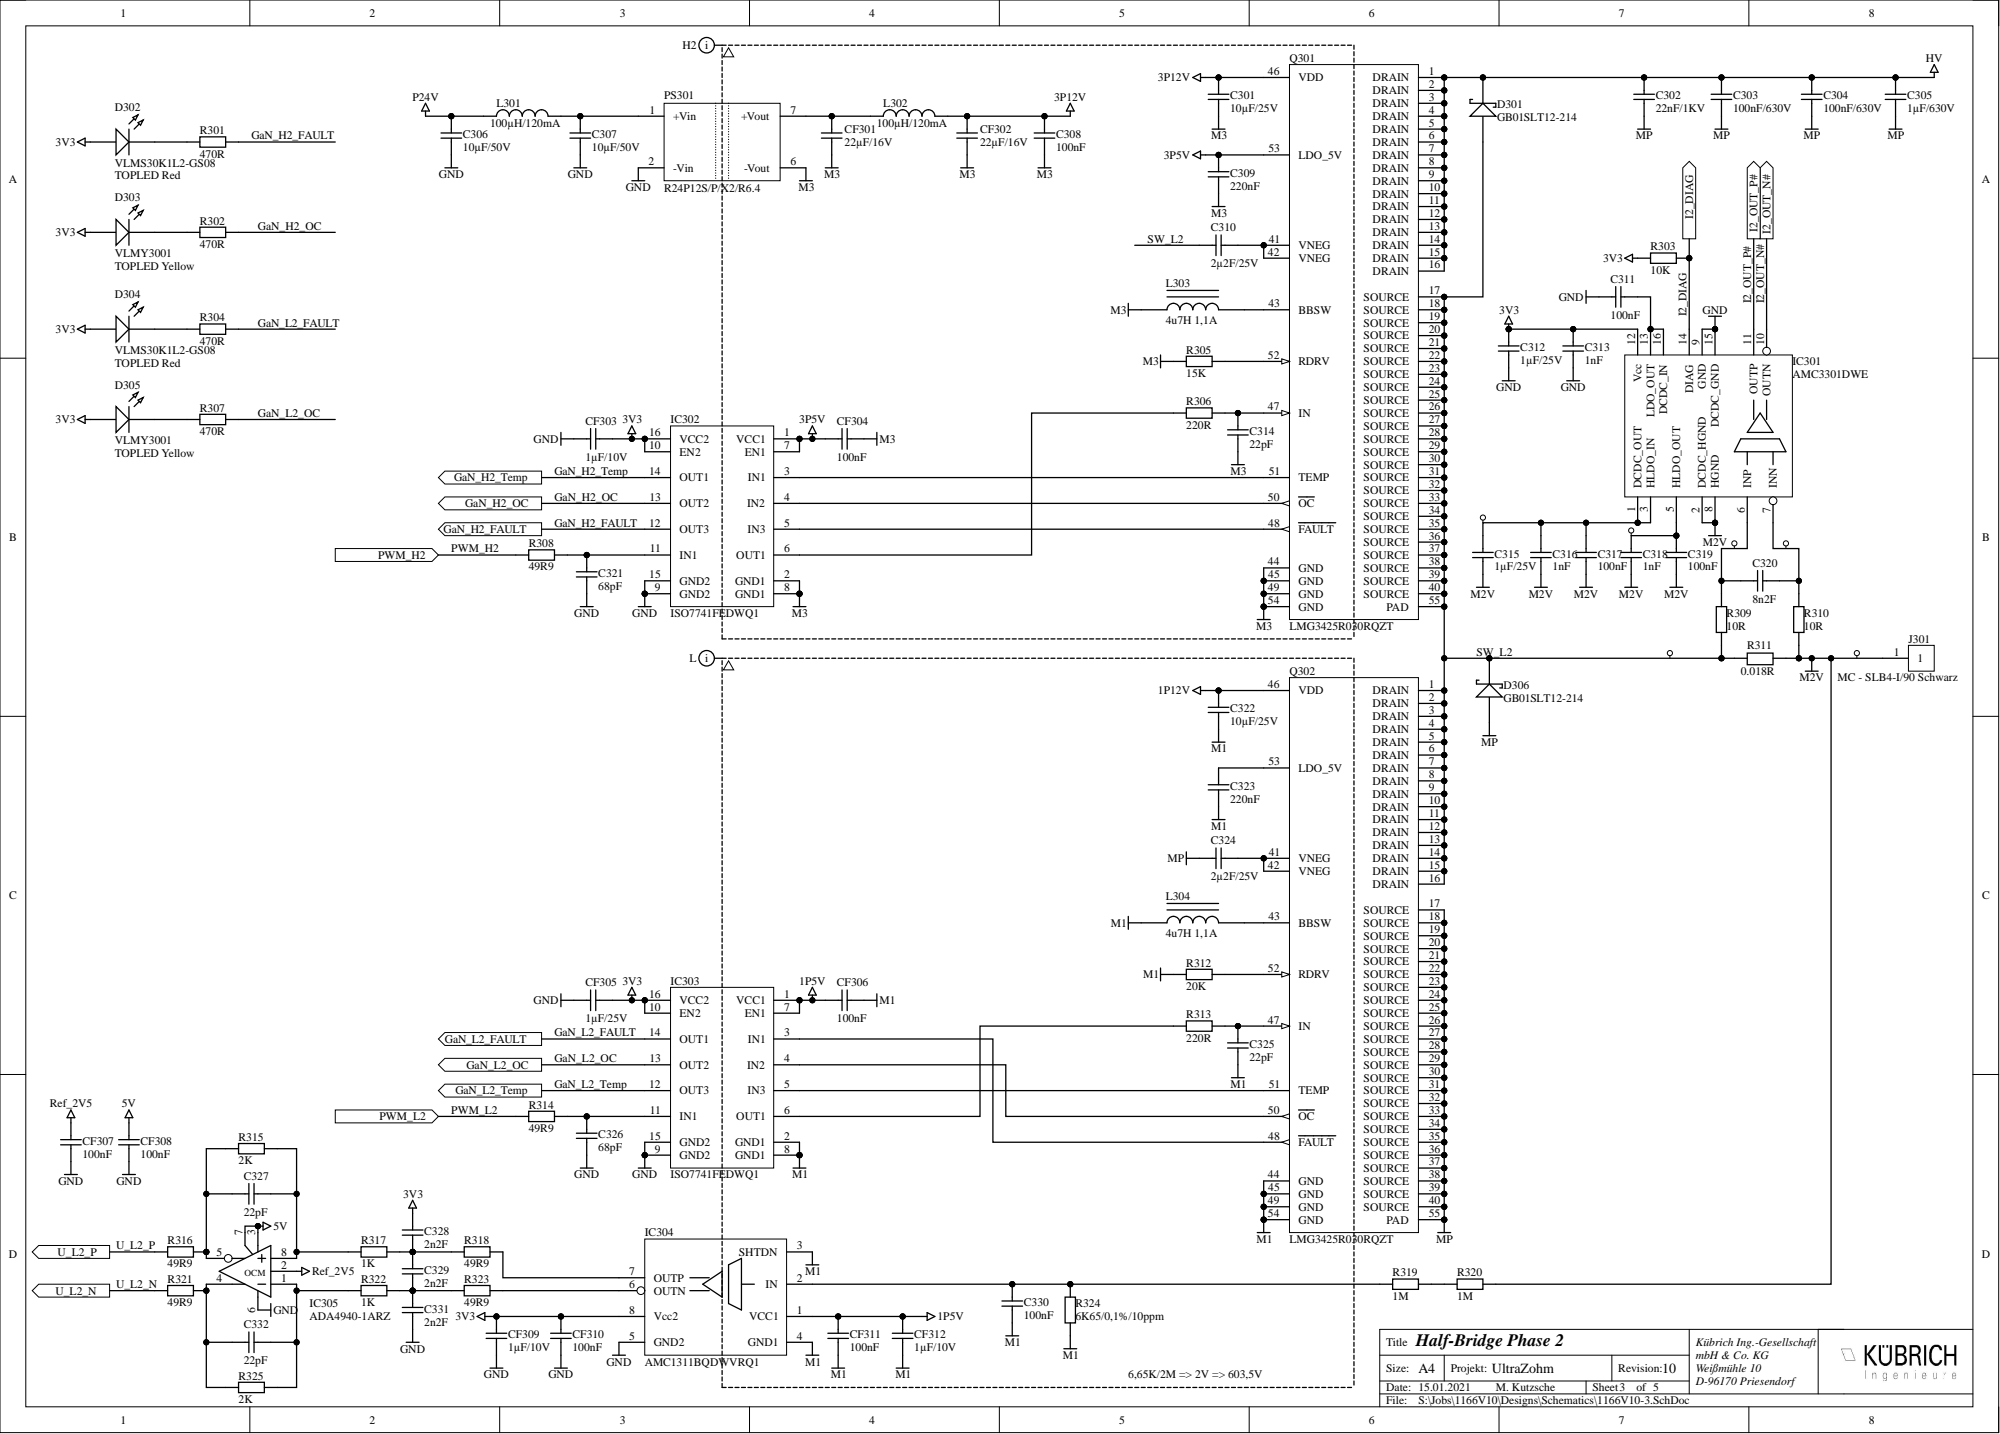
[picture p18: page 3]

3P5V CF304 | C314 M3 | TEMP 51

VCC2 16 | EN1 IN1 IN2 IN3
EN2 10 | | 7 | 100nF

OUT1 14 OUT2 13 OUT3 12 IN1 11 | 3

5 | | FAULT 48

VCC2 16 | EN1 IN2 IN3 OUT1 GND1
EN2 10 | 7

TEMP 51

GND2 9 GND2 15 | | | GND 44

2 | FAULT 48

OUTP 7

S:\Jobs\1166V10\Designs\Schematics\1166V10-3.SchDoc

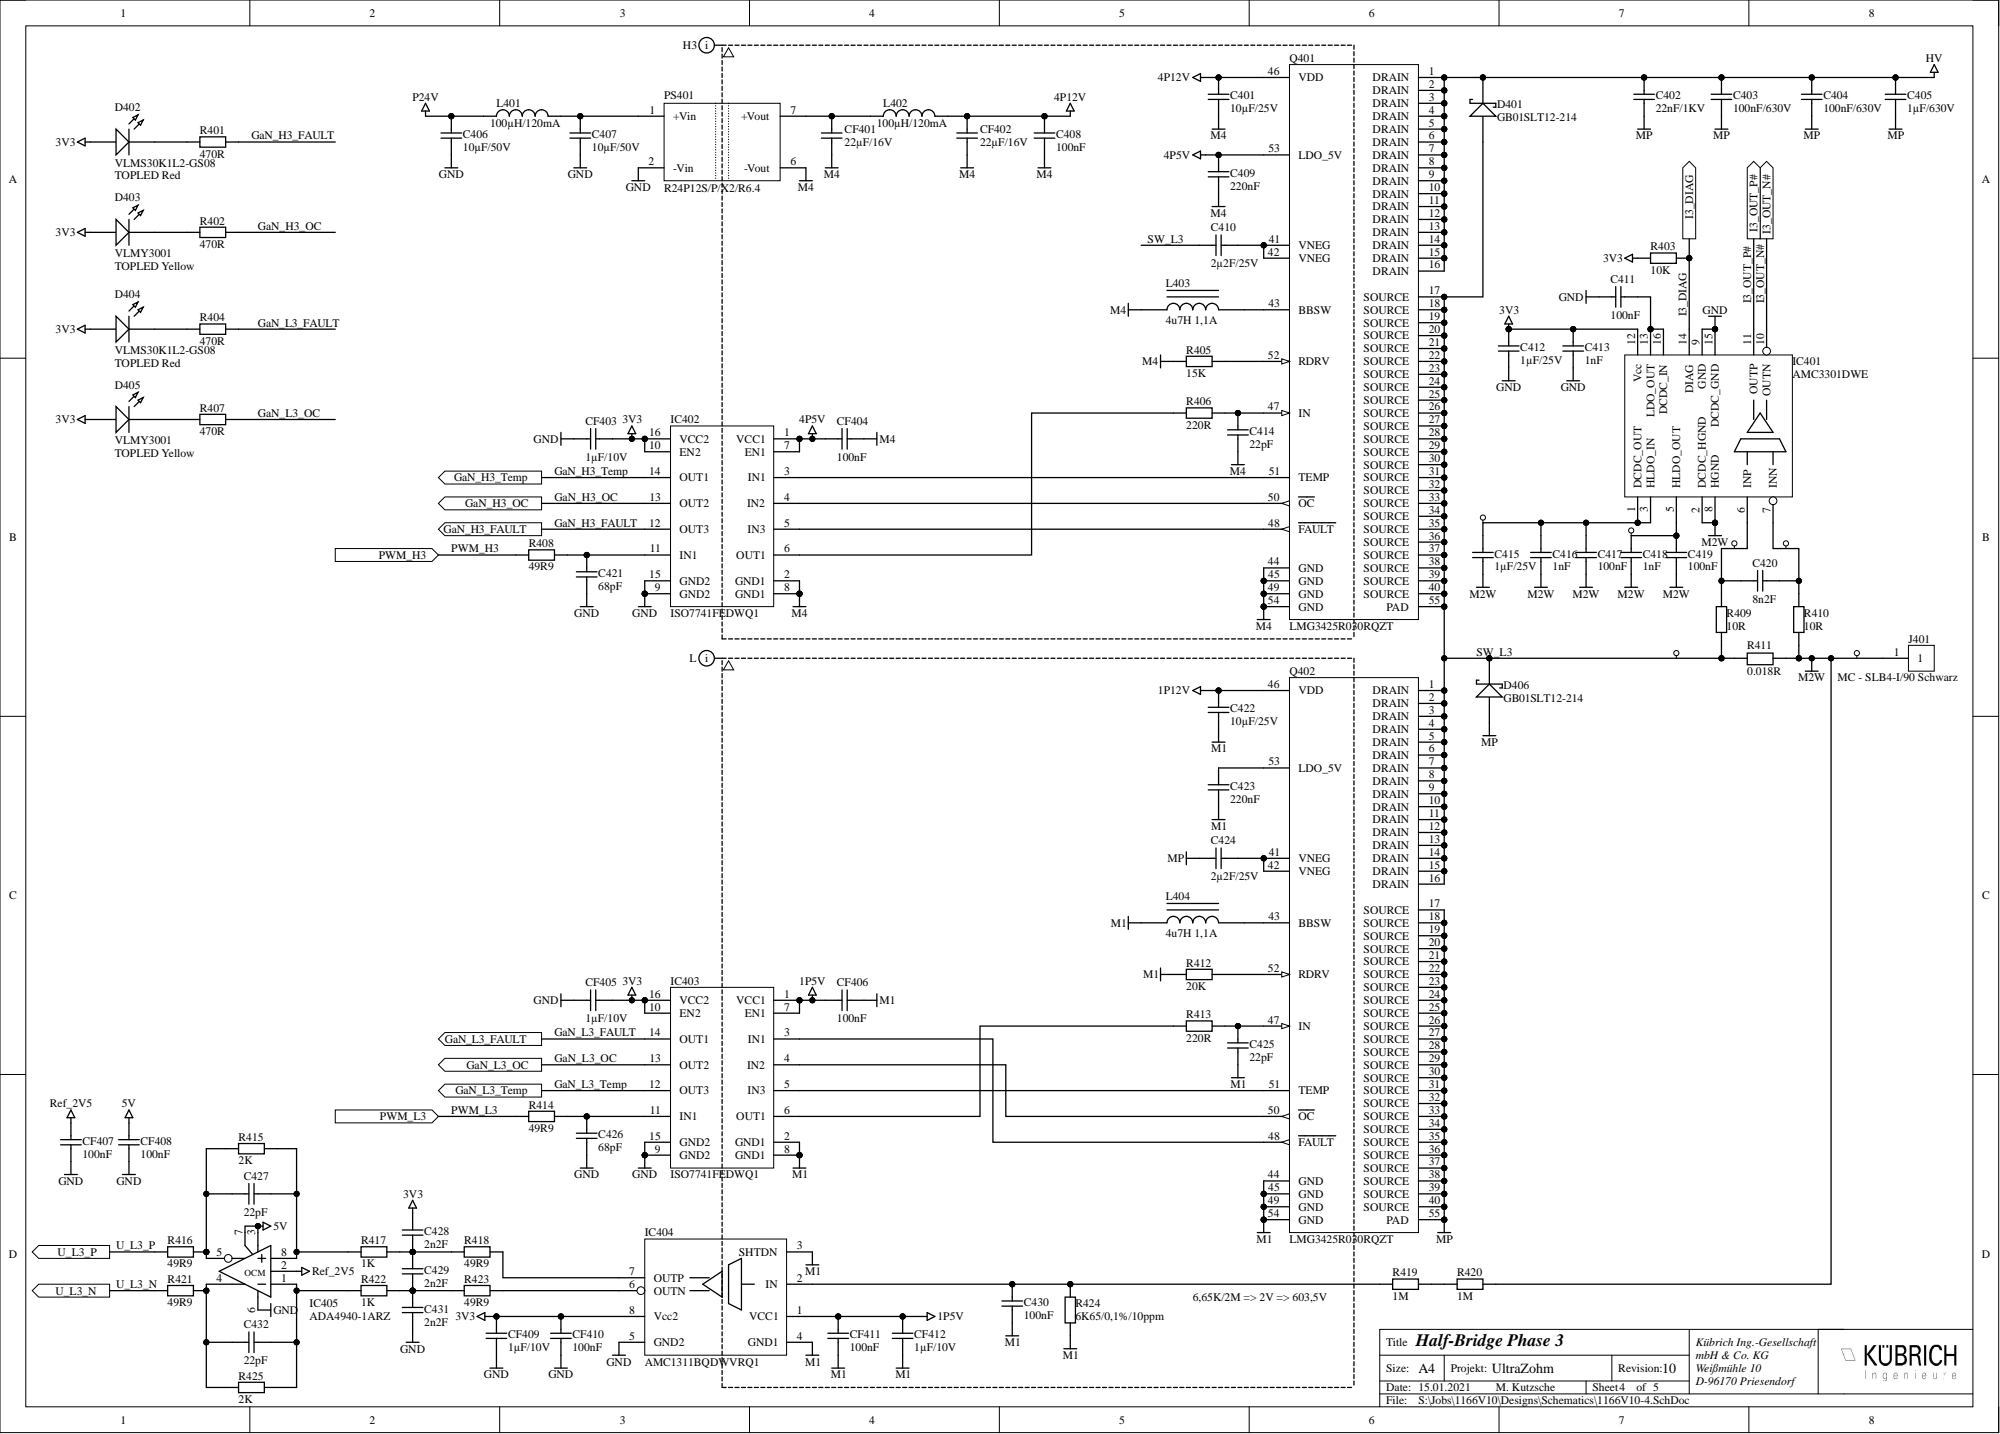
[picture p19: page 4]

4P5V CF404 | C414 M4 | TEMP 51

VCC2 16 | EN1 IN1 IN2 IN3
EN2 10 | | 7 | 100nF

OUT1 14 OUT2 13 OUT3 12 IN1 11 | 3

5 | | FAULT 48

VCC2 16 | EN1 IN2 IN3 OUT1 GND1
EN2 10 | 7

TEMP 51

GND2 9 GND2 15 | | | GND 44

2 | FAULT 48

S:\Jobs\1166V10\Designs\Schematics\1166V10-4.SchDoc

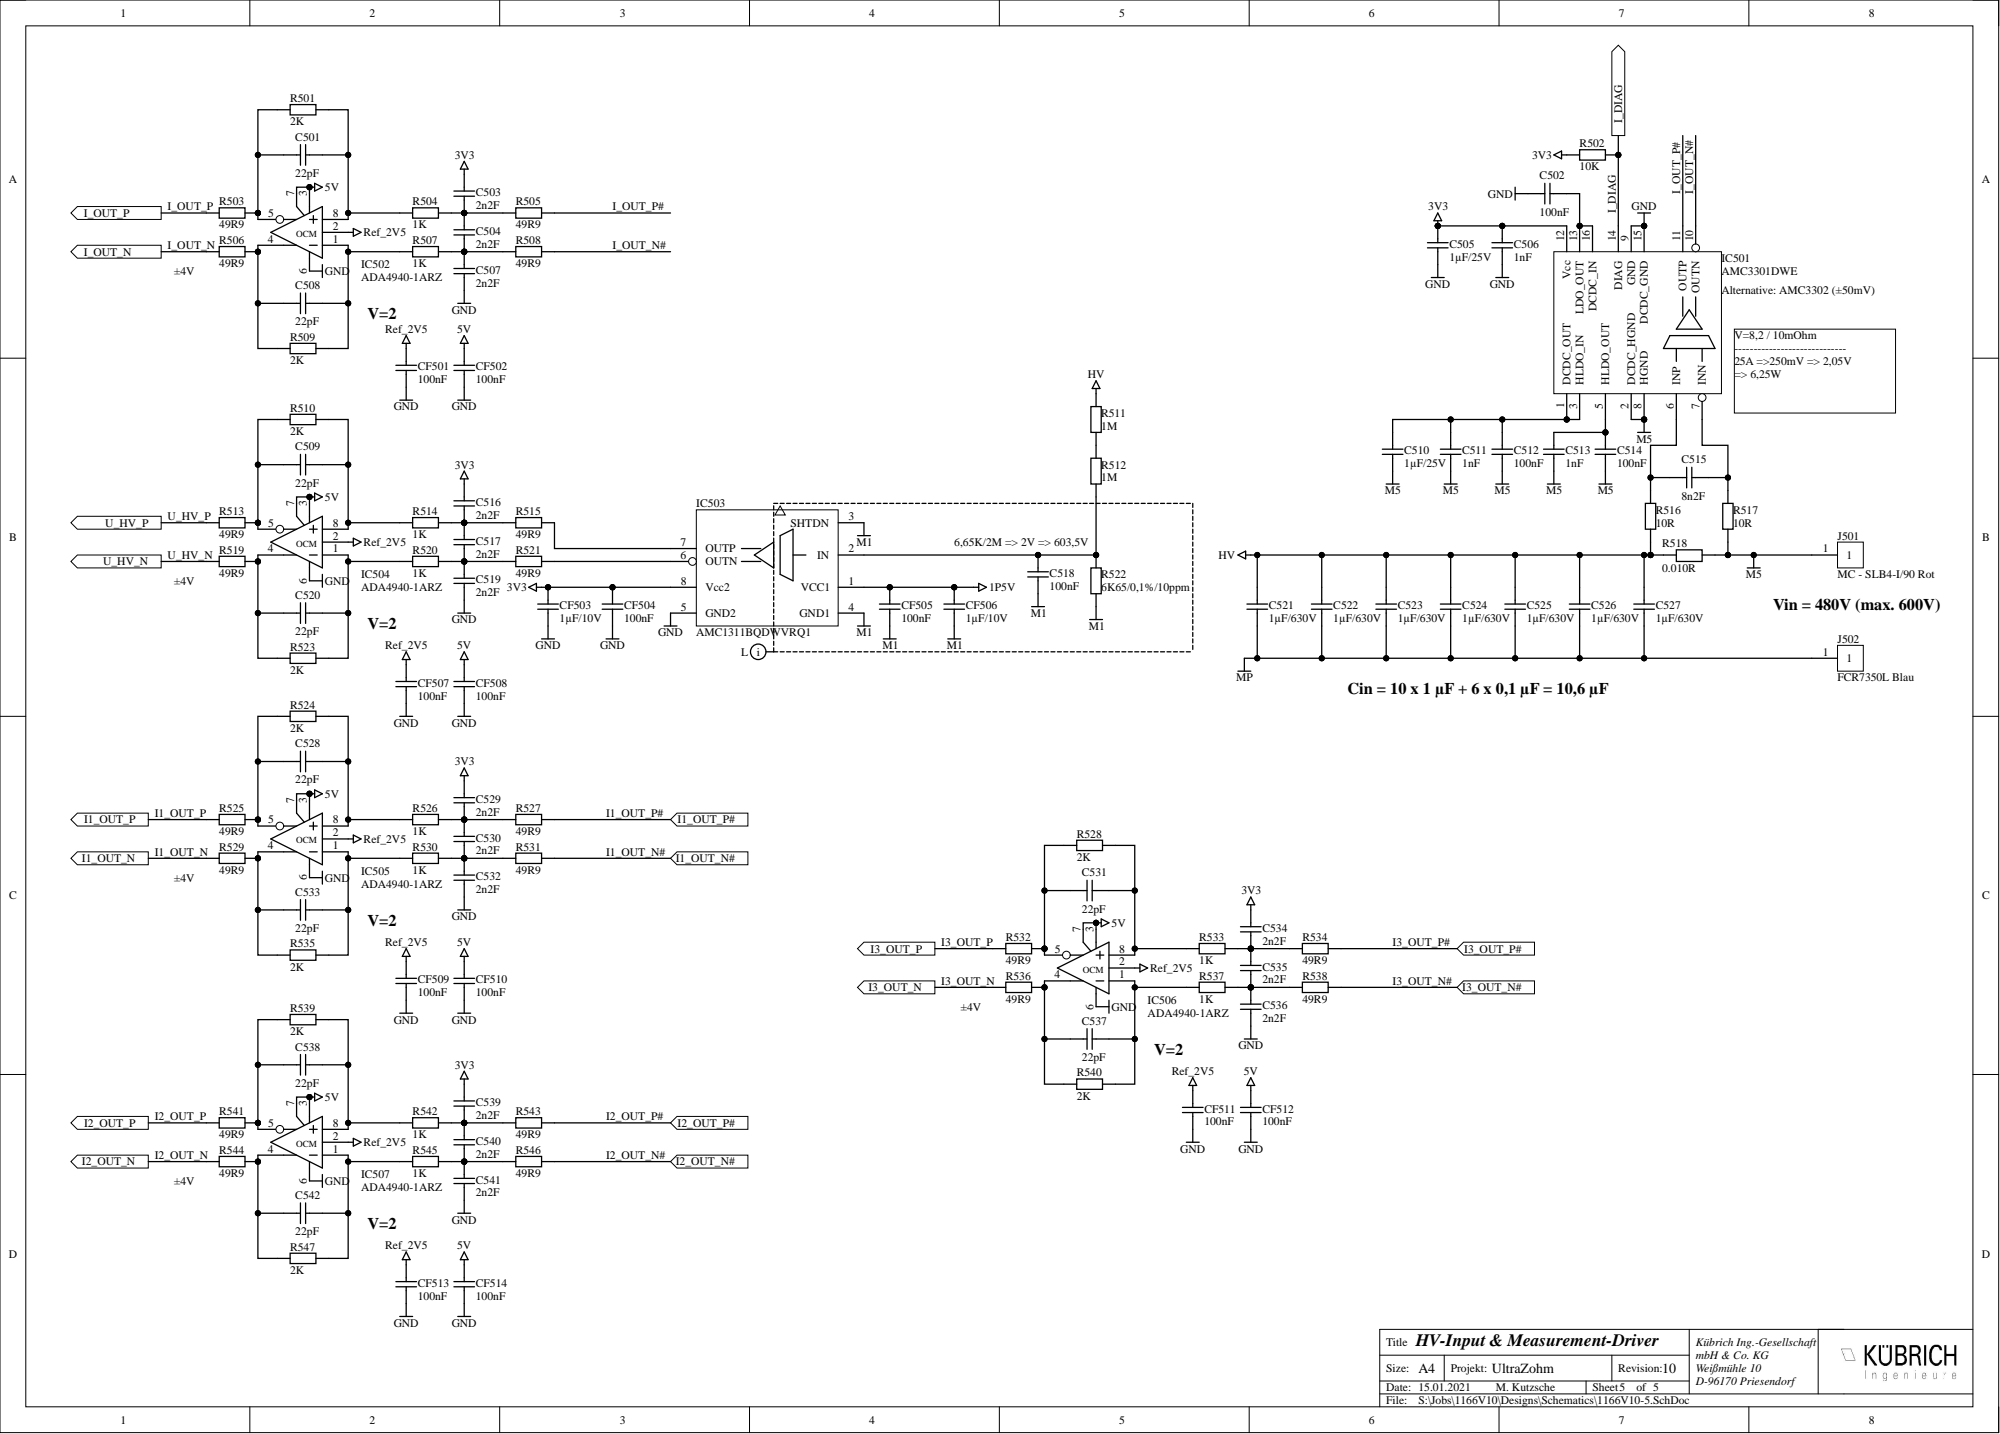
[picture p20: page 5]

OUTP 7

GND | Vcc2 8

Cin = 10 x 1 µF + 6 x 0,1 µF = 10,6 µF

HV-Input & Measurement-Driver

S:\Jobs\1166V10\Designs\Schematics\1166V10-5.SchDoc
