ultrazohm/uz_d_gan_inverter/Produce/Prints/1166V10 Bestückung.PDF

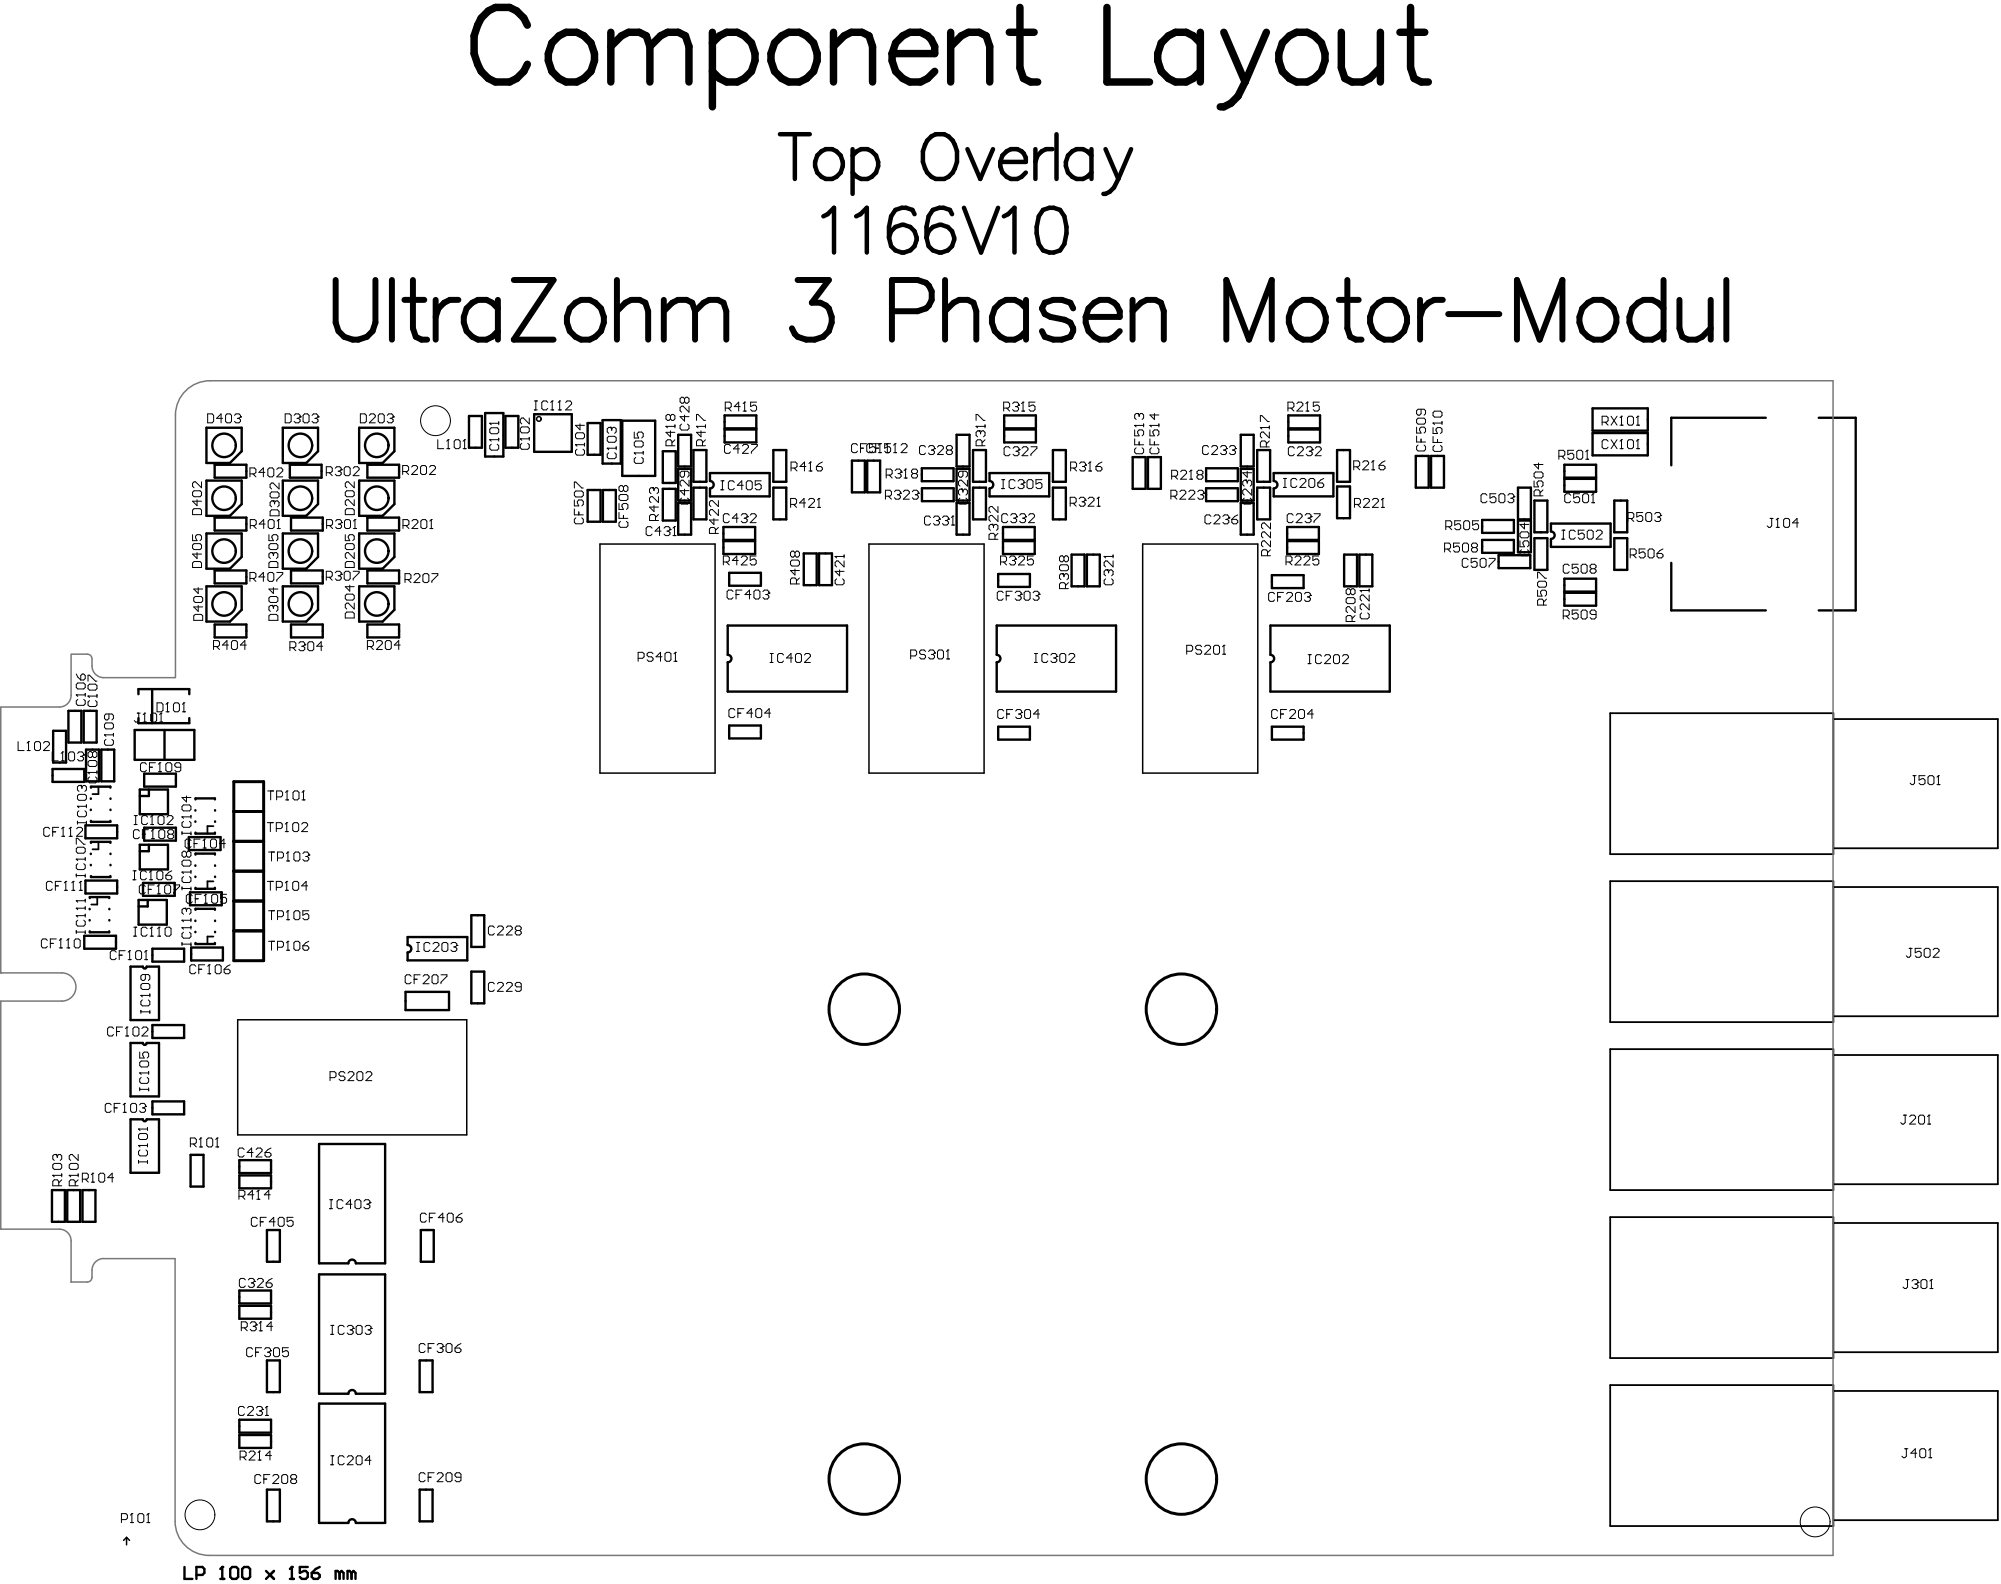
[picture p21: page 1]

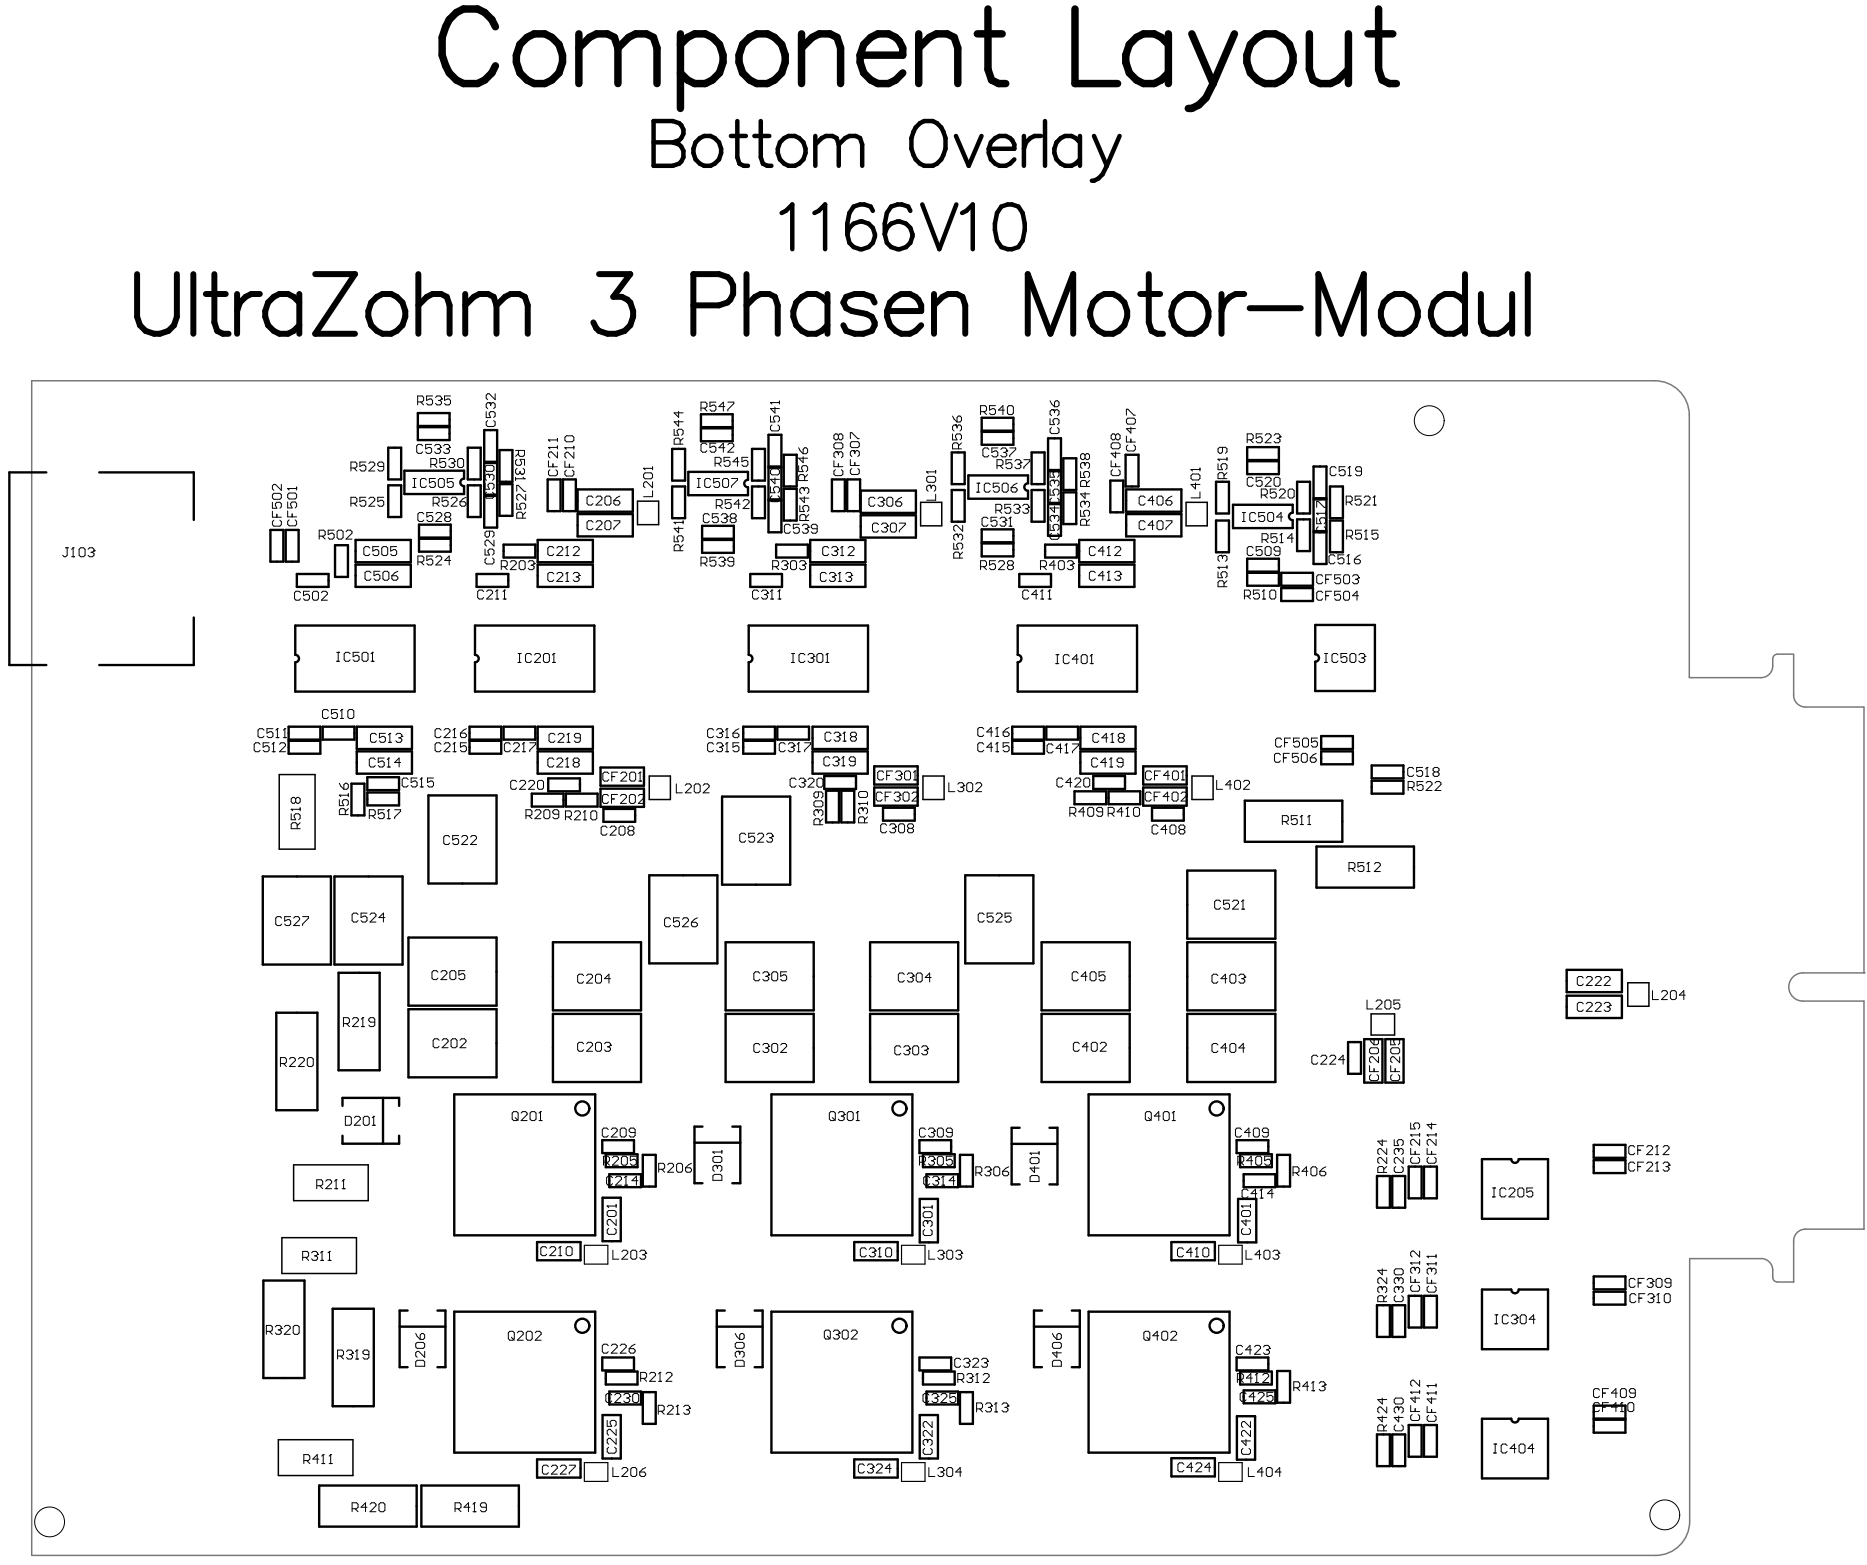
[picture p22: page 2]
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
