ultrazohm/uz_d_gan_inverter/Produce/Prints/1166V10 PCB 3D Prints.pdf

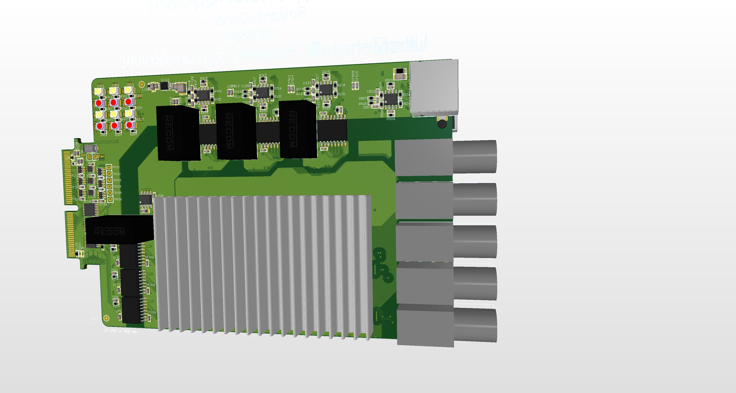
[picture p23: page 1]
