ultrazohm/uz_d_gan_inverter/Produce/Prints/1166V00 PCB 3D Prints.pdf

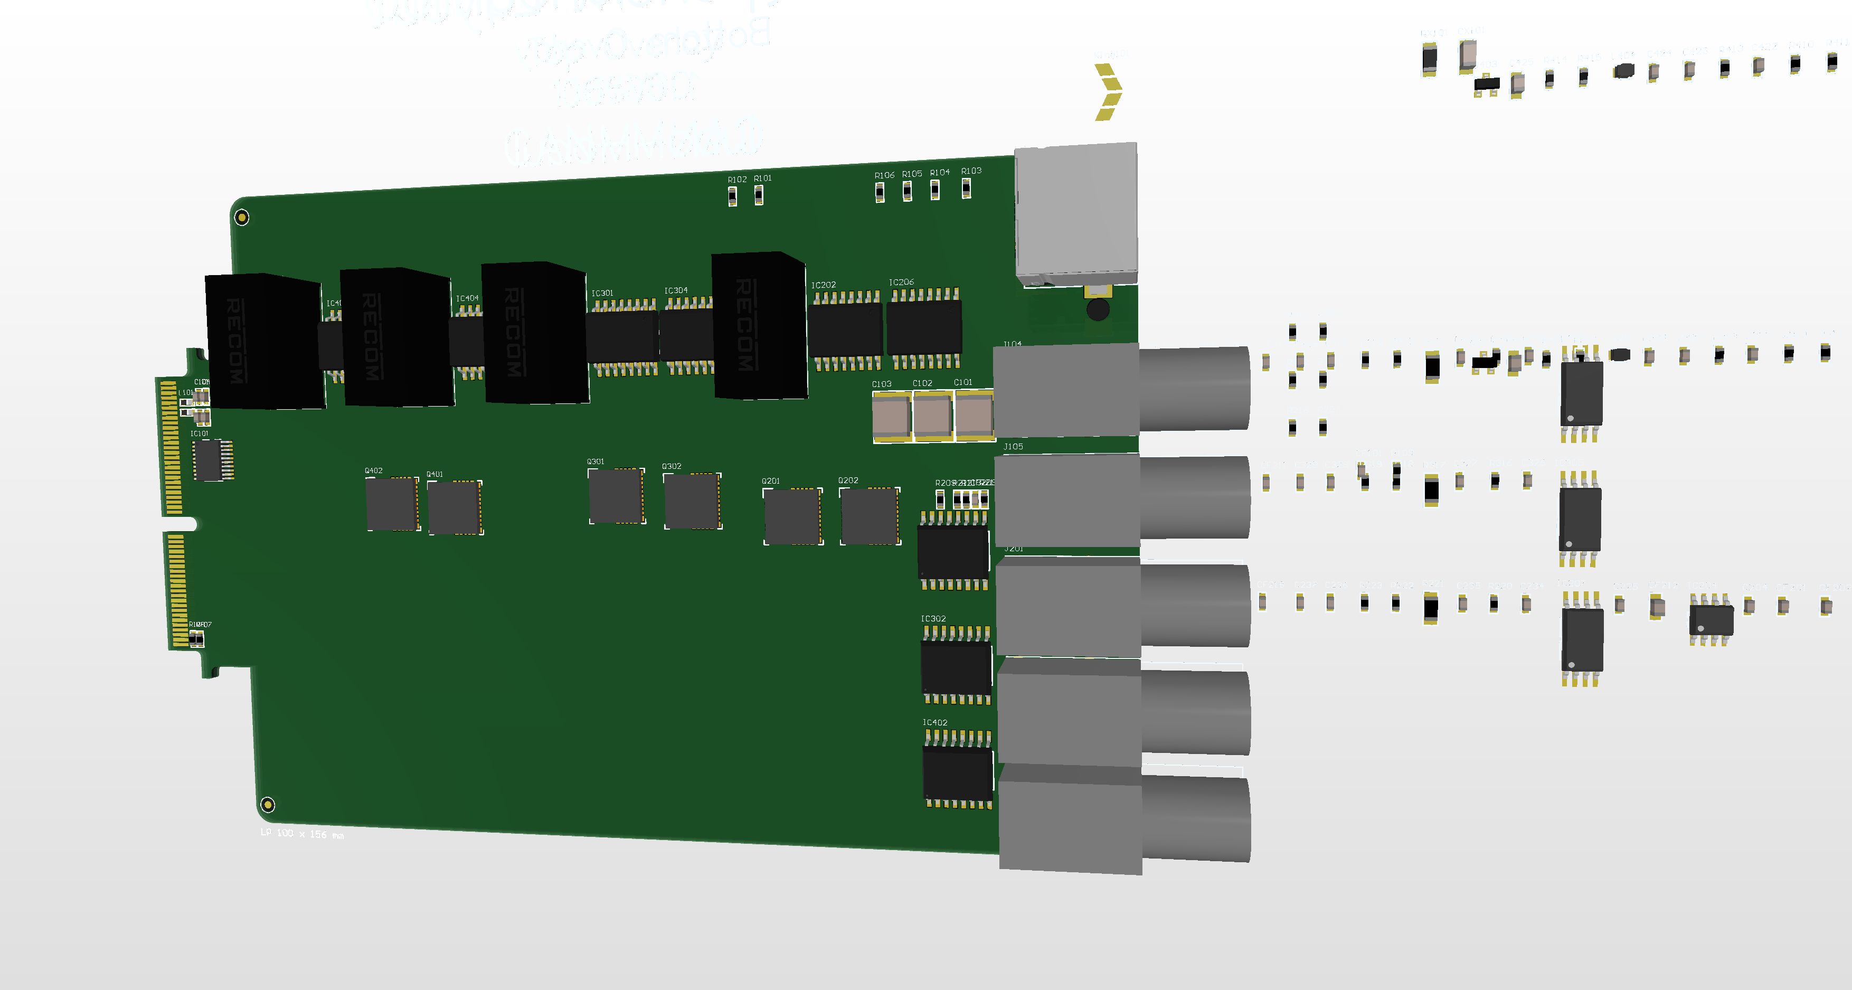
[picture p24: page 1]
