ultrazohm/uz_d_gan_inverter/(list of files, drawings)

Other design files:
Designs/1166V10.PrjPCB
Designs/Schematics/1166V10-1.SchDoc
Designs/Schematics/1166V10-2.SchDoc
Designs/Schematics/1166V10-3.SchDoc
Designs/Schematics/1166V10-4.SchDoc
Designs/Schematics/1166V10-5.SchDoc
