ultrazohm/uz_d_gan_inverter/(commit log)

2021-01-08 deleted template files and added kuebrich own files and current version
    [1166V10-1.SchDoc, 1166V10-2.SchDoc, 1166V10-3.SchDoc, 1166V10-4.SchDoc, 1166V10-5.SchDoc, 1166V10.PrjPCB, DigitalCarrierJack.SchDoc, TopSheet.SchDoc]
2021-01-12 - Aktualisierung Schaltplan und Layout von M.Kutzsche - Added CAD and docs files M.Hoerner
    [1160V01 Stückliste.xls, 1166V10-1.SchDoc, 1166V10-2.SchDoc, 1166V10-3.SchDoc, 1166V10-4.SchDoc, 1166V10-5.SchDoc, 1166V10.PrjPCB]
2021-03-26 Archivierung der produzierten V1.0
    [1160V10 Stückliste.xls, 1166V10-1.SchDoc, 1166V10-5.SchDoc, 1166V10.PrjPCB, Pick Place for 1166V10(Variant V10).csv]
2021-09-15 added some doc files and CAD files
    [20210902_Messung_GaN.xlsx, GaN_TempSignal_TempOverDutycyc.xlsx, UZ_D_GaNInverter_Panel.SLDPRT, UZ_D_GaN_Inverter.dxf]
2022-02-21 added water cooled heatsink CAD files
    [Assembly_water_cooled.SLDASM, heatsink.SLDPRT, heatsink.STEP, heatsink2.SLDPRT, heatsink2.STEP, heatsink_assembly.SLDASM, heatsink_cover.STEP, heatsink_plate.SLDPRT]
2022-03-02 added measurements: compared air and water cooled performance
    [20220302_GaN_Air_vs_Water_Cooling.xlsx]
2022-06-03 some documents
    [1160V01 Stückliste.xls, 1160V10 Stückliste.xls]
